charancs926-png/Meridian-W104/Images/Fusion Timeline.png

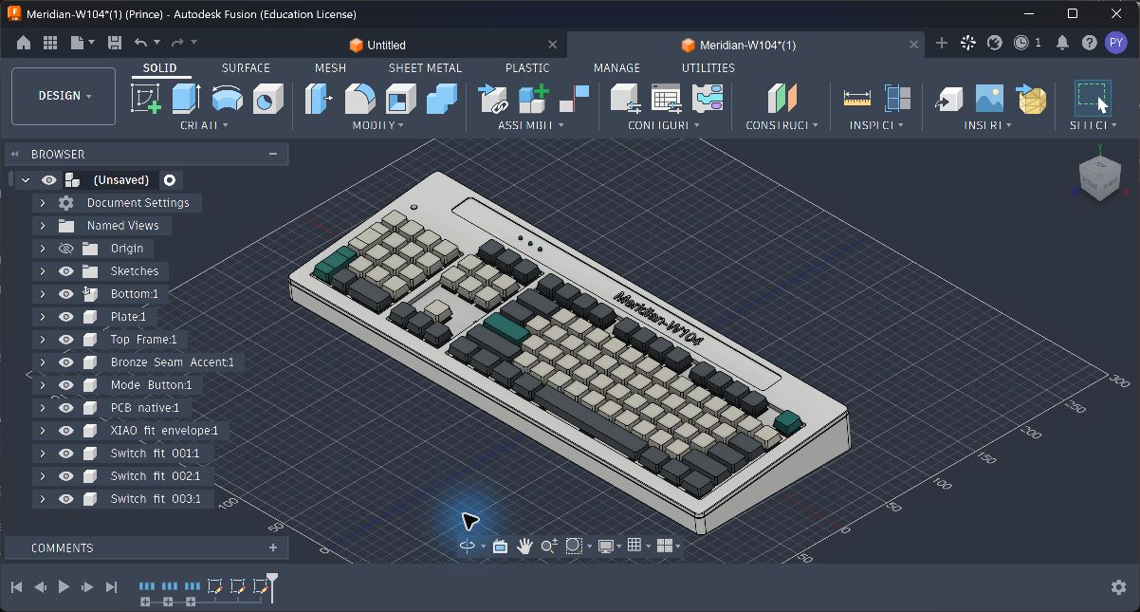
Images/Fusion Timeline.png
