charancs926-png/Meridian-W104/Images/KiCad PCB Bottom 3D.png

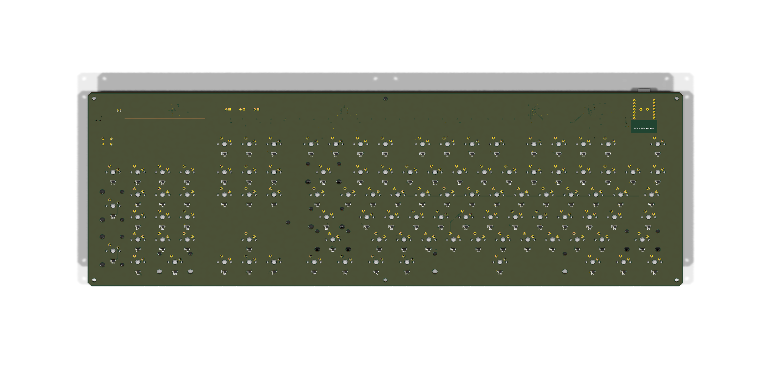
Images/KiCad PCB Bottom 3D.png
