charancs926-png/Meridian-W104/Images/PCB Layer 1.png

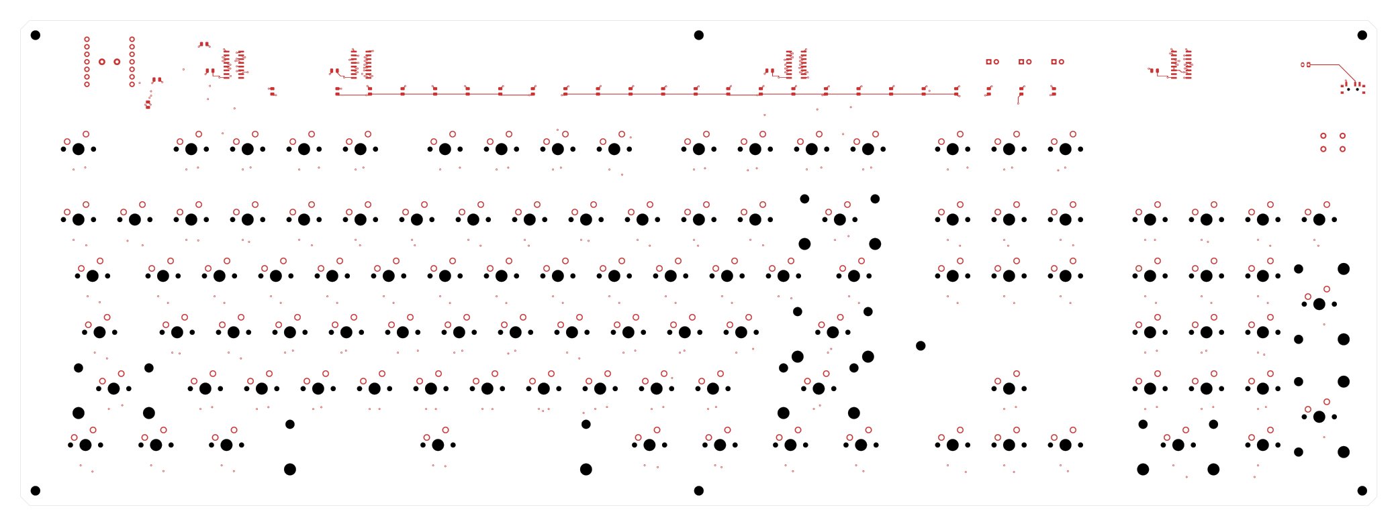
Images/PCB Layer 1.png
