charancs926-png/Meridian-W104/Images/PCB Layer 2.png

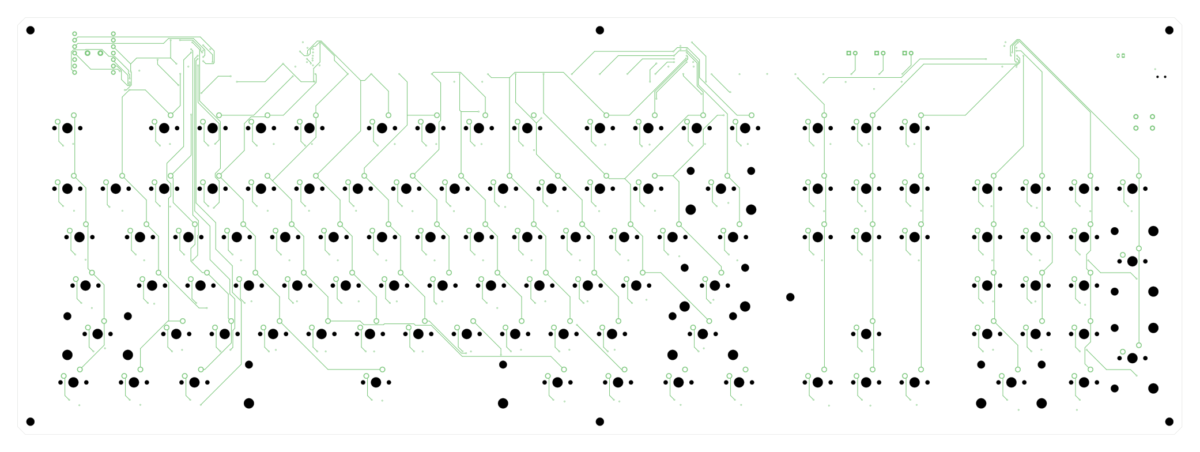
Images/PCB Layer 2.png
