charancs926-png/Meridian-W104/Images/PCB Layer 3.png

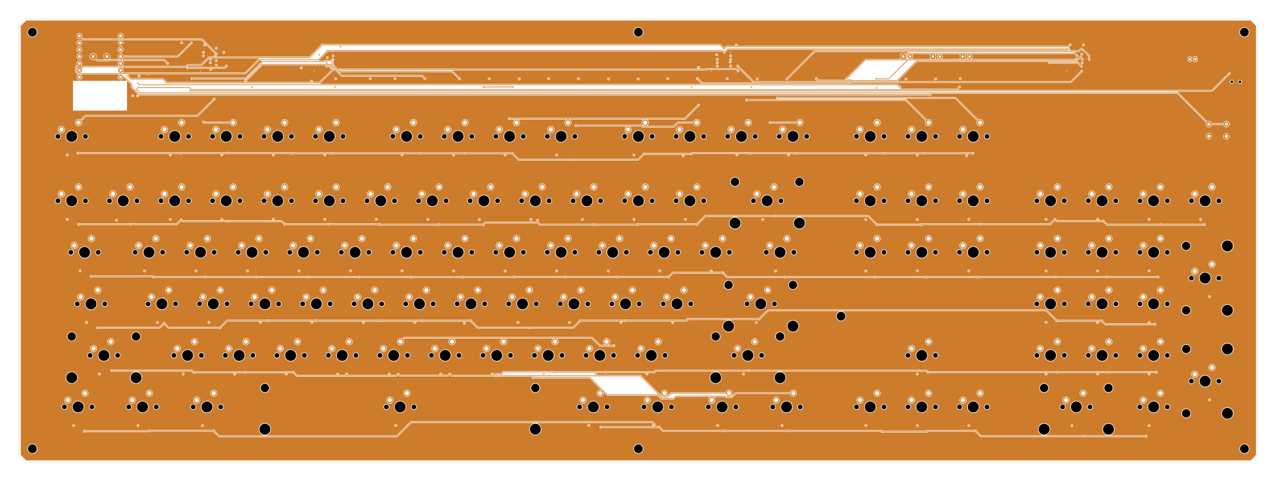
Images/PCB Layer 3.png
