charancs926-png/Meridian-W104/Images/PCB Layer 4.png

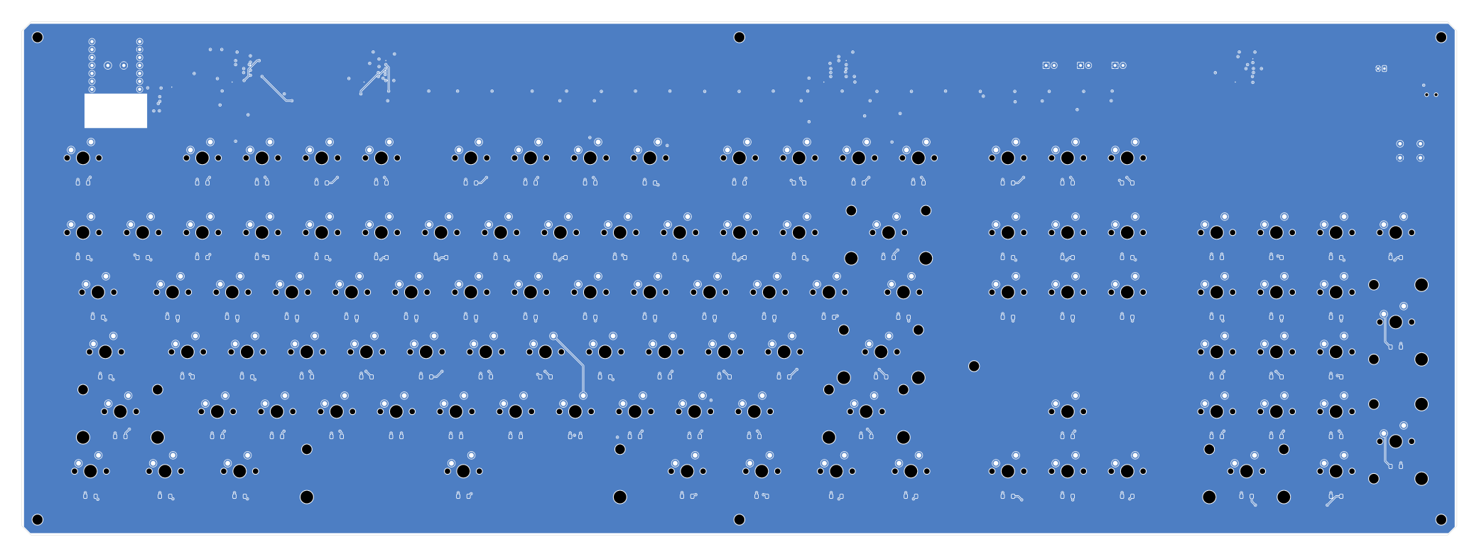
Images/PCB Layer 4.png
