charancs926-png/Meridian-W104/Images/PCB Layer 5.png

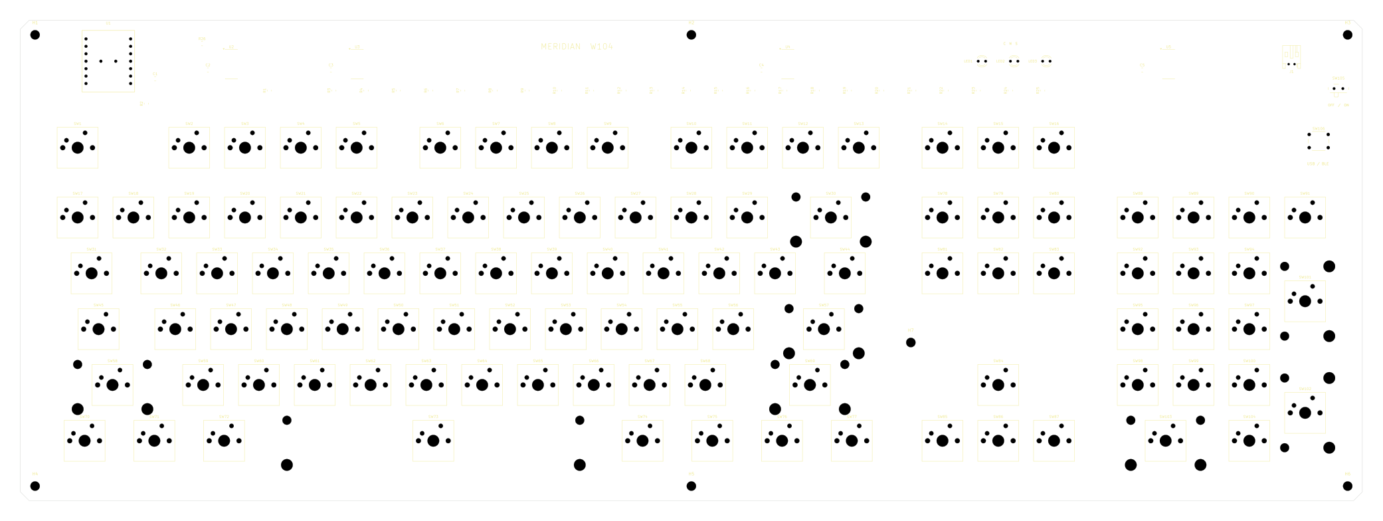
Images/PCB Layer 5.png
