charancs926-png/Meridian-W104/bom.csv

Name | Purpose | Quantity | TotalCost (INR) | UnitCost (INR) | TotalCostUSD | Link | Distributor
XIAO nRF52840 non-Plus | BLE / USB controller and module charger | 1 | 1451 | 1451 | 15.06 | https://www.lioncircuits.com/parts/102010448 | LionCircuits
SN74HC595D SOIC-16 | 6 row sink outputs | 1 | 32.2 | 16.1 | 0.33 | https://www.ktron.in/product/74hc595d-8-bit-shift-register-ic-smd/ | KTRON
SN74HC165D SOIC-16 | 22 column samples | 3 | 59.4 | 19.8 | 0.62 | https://www.ktron.in/product/74hc165d-ic-8-bit-shift-register-soic-16-nxp/ | KTRON
Cherry MX PCB-pattern switch, 5-pin | Soldered keys | 104 | 3850 | 350 | 39.96 | https://stackskb.com/store/menel-eight-nine-haku-linear-switch-pack-of-10/ | StacksKB
1N4148W SOD-123 | Per-key isolation | 104 | 108.16 | 1.04 | 1.12 | https://robu.in/product/1n4148w-slkor-75v-1v-4ns-150ma-sod-123-switching-diodes-rohs/ | Robu
22k 0805 1% resistor | Column bias | 22 | 10.08 | 0.42 | 0.1 | https://robu.in/product/ac0805fr-0722kl-yageo-res-thick-film-0805-22k-ohm-1-0-125w1-8w-%c2%b1100ppm-c-pad-smd-t-r-automotive-aec-q200/ | Robu
1k 0805 resistor | Lock indicator current limit | 3 | 13.8 | 0.46 | 0.14 | https://robu.in/product/rc0805jr-071kl-yageo-res-thick-film-0805-1k-ohm-5-0-125w1-8w-%c2%b1100ppm-c-pad-smd-t-r/ | Robu
100k 0805 resistor | Row output enable default OFF | 1 | 13.5 | 0.27 | 0.14 | https://robu.in/product/0805w8f1003t5e-uniohm-royal-ohm-125mw-thick-film-resistors-150v-%c2%b1100ppm-%e2%84%83%c2%b11-100k%cf%89-0805-chip-resistor-surface-mo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 | Robu
100n 0805 X7R, 10V or above | Logic decoupling | 4 | 30 | 1 | 0.31 | https://www.flyrobo.in/0805-100nf-50v-chip-capacitors | Flyrobo
10u 0805 X5R, 10V or above | Rail bulk capacitor | 1 | 10.6 | 2.65 | 0.11 | https://robu.in/product/08053d106kat2a-kyocera-avx-smd-multilayer-ceramic-capacitor-10-%c2%b5f-25-v-0805-2012-metric-%c2%b1-10-x5r/ | Robu
3mm LED, diffused, Vf compatible with 3.3V | Caps / Num / Scroll indicators | 3 | 18.8 | 0.94 | 0.2 | https://www.ktron.in/product/red-led-red-diffusion-3mm-th/ | KTRON
JST PH S2B-PH-K horizontal 2-pin | Battery connector | 1 | 16 | 8 | 0.17 | https://robu.in/product/s2b-ph-klfsn-jst-1x2p-2p-ph-tin-2-25%e2%84%8385%e2%84%83-2a-1-2mm-brass-bend-insert-push-pullp2mm-wire-to-board-connector-rohs/ | Robu
PCM12-pattern SMD SPDT slide switch | Battery disconnect | 1 | 66 | 66 | 0.68 | https://robu.in/product/pcm12smtr-ck-standing-paste-single-pole-double-throw-spdt-6v-smd-slide-switches-rohs/ | Robu
6mm THT tactile pushbutton | Transport toggle / bond reset | 1 | 3 | 3 | 0.03 | https://www.tomsonelectronics.com/products/tactile-push-button-micro-switch-6x6x4-3mm | Tomson
Protected 3.7V 500mAh LiPo 502248P (bare leads) | Wireless power; maximum assembled envelope 60x28x6mm | 1 | 299 | 299 | 3.1 | https://probots.co.in/3-7v-500mah-lipo-battery-502248-open-ended.html | Probots
JST-PH2.0 2-pin female pigtail to bare wire | Adapt protected bare-lead battery to J1 | 1 | 4.13 | 4.13 | 0.04 | https://hubtronics.in/connectors/relimate_connectors/board_to_wire_relimate/1508 | Hubtronics
7-pin 2.54mm headers | Module mounting; two rows | 2 | 40 | 8 | 0.42 | https://www.flyrobo.in/40-pin-male-header-connector-strip-breakable-5pcs | Flyrobo
Flexible insulated wire | Module underside BAT+ / BAT- leads | 2 | 24 | 6 | 0.25 | https://robu.in/product/high-quality-ultra-flexible-28awg-silicone-wire-1000m-red/ | Robu
ANSI 104-key MX keycap set | User keycaps; 6.25u spacebar | 1 | 1000 | 1000 | 10.38 | https://stackskb.com/store/stackspbt-blank-white-cherry-profile-keycaps-113-key/ | StacksKB
Durock V2 PCB screw-in stabilizer kit (7x2U + 1x6.25U) | Seven wide keys and 6.25U spacebar | 1 | 2365 | 2365 | 24.54 | https://stackskb.com/store/durock-clear-screw-in-stabilizers-v2/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 | StacksKB
M3x30mm DIN912 socket-head SS304 screws (10pc pack) | 3 concealed rear mounts | 1 | 116 | 116 | 1.2 | https://rpishop.in/products/ss-allen-cap-m3?variant=45146051510424 | RPI Shop
M3x15mm DIN912 socket-head SS304 screws (10pc pack) | 3 concealed front mounts | 1 | 88 | 88 | 0.91 | https://rpishop.in/products/ss-allen-cap-m3?variant=45146051412120 | RPI Shop
M3x20mm DIN912 socket-head SS304 screws (10pc pack) | 1 concealed centre mounts | 1 | 92 | 92 | 0.95 | https://rpishop.in/products/ss-allen-cap-m3?variant=45146051444888 | RPI Shop
M3 insert assortment; select 5mm long x4.2mm OD | Seven top-frame bosses, 3.9mm pilot holes | 1 | 1519 | 1519 | 15.76 | https://robu.in/product/brass-heat-set-insert-nut-hot-melt-knurled-threaded-m3-400pcs-kit/ | Robu
Meridian W104 four-layer PCB, 1.6mm | Final checked four-layer Gerber and drill package | 5 | 8647.58 | 1729.516 | 89.25 | https://cart.jlcpcb.com/shopcart/cart/ | JLCPCB
Printed case set | Bottom, plate, top frame, seam accent, mode button | 1 | 0 | 0 | 0 | https://printlegion.hackclub.com/ | Printing Legion
TOTAL |  |  | 19877.25 |  | 205.77
