charancs926-png/Meridian-W104/Fabrication/Assembly BOM.csv

Reference | Value | Footprint | Side | Technology | Notes
C1 | 10u / 10V | Capacitor_SMD:C_0805_2012Metric | Top | SMD
C2 | 100n | Capacitor_SMD:C_0805_2012Metric | Top | SMD
C3 | 100n | Capacitor_SMD:C_0805_2012Metric | Top | SMD
C4 | 100n | Capacitor_SMD:C_0805_2012Metric | Top | SMD
C5 | 100n | Capacitor_SMD:C_0805_2012Metric | Top | SMD
D1 | 1N4148W | Diode_SMD:D_SOD-123 | Bottom | SMD
D10 | 1N4148W | Diode_SMD:D_SOD-123 | Bottom | SMD
D100 | 1N4148W | Diode_SMD:D_SOD-123 | Bottom | SMD
D101 | 1N4148W | Diode_SMD:D_SOD-123 | Bottom | SMD
D102 | 1N4148W | Diode_SMD:D_SOD-123 | Bottom | SMD
D103 | 1N4148W | Diode_SMD:D_SOD-123 | Bottom | SMD
D104 | 1N4148W | Diode_SMD:D_SOD-123 | Bottom | SMD
D11 | 1N4148W | Diode_SMD:D_SOD-123 | Bottom | SMD
D12 | 1N4148W | Diode_SMD:D_SOD-123 | Bottom | SMD
D13 | 1N4148W | Diode_SMD:D_SOD-123 | Bottom | SMD
D14 | 1N4148W | Diode_SMD:D_SOD-123 | Bottom | SMD
D15 | 1N4148W | Diode_SMD:D_SOD-123 | Bottom | SMD
D16 | 1N4148W | Diode_SMD:D_SOD-123 | Bottom | SMD
D17 | 1N4148W | Diode_SMD:D_SOD-123 | Bottom | SMD
D18 | 1N4148W | Diode_SMD:D_SOD-123 | Bottom | SMD
D19 | 1N4148W | Diode_SMD:D_SOD-123 | Bottom | SMD
D2 | 1N4148W | Diode_SMD:D_SOD-123 | Bottom | SMD
D20 | 1N4148W | Diode_SMD:D_SOD-123 | Bottom | SMD
D21 | 1N4148W | Diode_SMD:D_SOD-123 | Bottom | SMD
D22 | 1N4148W | Diode_SMD:D_SOD-123 | Bottom | SMD
D23 | 1N4148W | Diode_SMD:D_SOD-123 | Bottom | SMD
D24 | 1N4148W | Diode_SMD:D_SOD-123 | Bottom | SMD
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
SW86 | 1u | Button_Switch_Keyboard:SW_Cherry_MX_1.00u_PCB | Top | THT | Soldered MX PCB switches, not hot-swap.
SW87 | 1u | Button_Switch_Keyboard:SW_Cherry_MX_1.00u_PCB | Top | THT | Soldered MX PCB switches, not hot-swap.
SW88 | 1u | Button_Switch_Keyboard:SW_Cherry_MX_1.00u_PCB | Top | THT | Soldered MX PCB switches, not hot-swap.
SW89 | 1u | Button_Switch_Keyboard:SW_Cherry_MX_1.00u_PCB | Top | THT | Soldered MX PCB switches, not hot-swap.
SW9 | 1u | Button_Switch_Keyboard:SW_Cherry_MX_1.00u_PCB | Top | THT | Soldered MX PCB switches, not hot-swap.
SW90 | 1u | Button_Switch_Keyboard:SW_Cherry_MX_1.00u_PCB | Top | THT | Soldered MX PCB switches, not hot-swap.
SW91 | 1u | Button_Switch_Keyboard:SW_Cherry_MX_1.00u_PCB | Top | THT | Soldered MX PCB switches, not hot-swap.
SW92 | 1u | Button_Switch_Keyboard:SW_Cherry_MX_1.00u_PCB | Top | THT | Soldered MX PCB switches, not hot-swap.
SW93 | 1u | Button_Switch_Keyboard:SW_Cherry_MX_1.00u_PCB | Top | THT | Soldered MX PCB switches, not hot-swap.
SW94 | 1u | Button_Switch_Keyboard:SW_Cherry_MX_1.00u_PCB | Top | THT | Soldered MX PCB switches, not hot-swap.
SW95 | 1u | Button_Switch_Keyboard:SW_Cherry_MX_1.00u_PCB | Top | THT | Soldered MX PCB switches, not hot-swap.
SW96 | 1u | Button_Switch_Keyboard:SW_Cherry_MX_1.00u_PCB | Top | THT | Soldered MX PCB switches, not hot-swap.
SW97 | 1u | Button_Switch_Keyboard:SW_Cherry_MX_1.00u_PCB | Top | THT | Soldered MX PCB switches, not hot-swap.
SW98 | 1u | Button_Switch_Keyboard:SW_Cherry_MX_1.00u_PCB | Top | THT | Soldered MX PCB switches, not hot-swap.
SW99 | 1u | Button_Switch_Keyboard:SW_Cherry_MX_1.00u_PCB | Top | THT | Soldered MX PCB switches, not hot-swap.
U1 | XIAO nRF52840 | Meridian:XIAO_Carrier | Top | THT | Original XIAO nRF52840 non-Plus on two 7-pin headers. BAT+/- underside pads wired to carrier pads 15/16; do not treat as header pins.
U2 | SN74HC595D | Package_SO:SOIC-16_3.9x9.9mm_P1.27mm | Top | SMD
U3 | SN74HC165D | Package_SO:SOIC-16_3.9x9.9mm_P1.27mm | Top | SMD
U4 | SN74HC165D | Package_SO:SOIC-16_3.9x9.9mm_P1.27mm | Top | SMD
U5 | SN74HC165D | Package_SO:SOIC-16_3.9x9.9mm_P1.27mm | Top | SMD
