charancs926-png/Meridian-W104/BOM Images/Flyrobo Cart.jpg

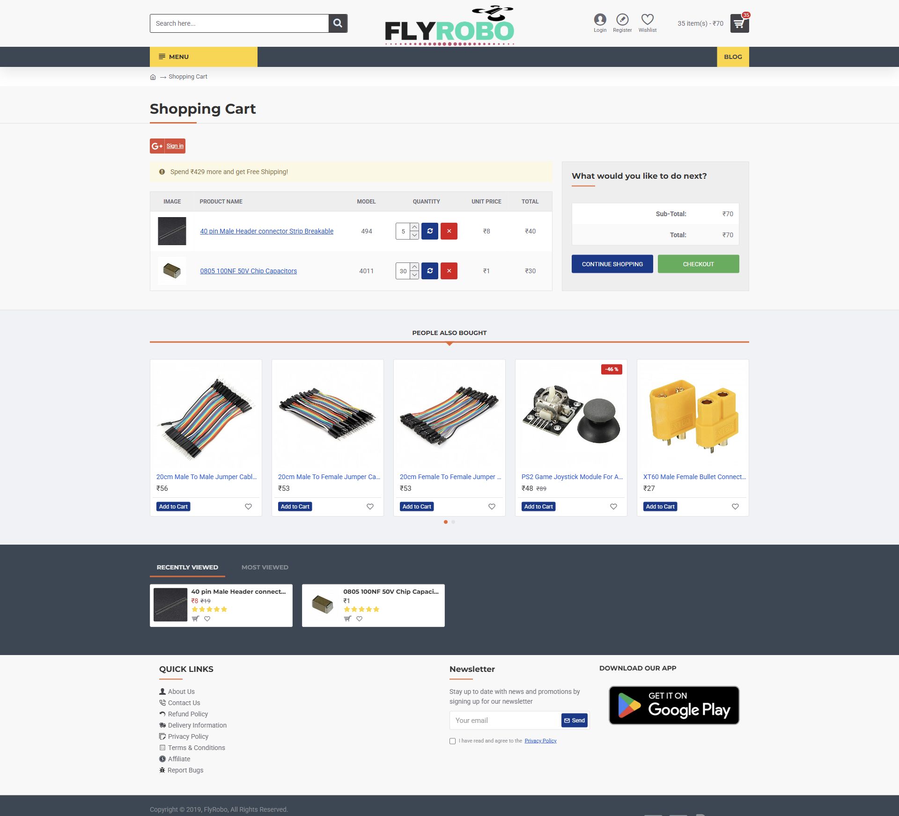
BOM Images/Flyrobo Cart.jpg
