charancs926-png/Meridian-W104/BOM Images/Hubtronics Cart.jpg

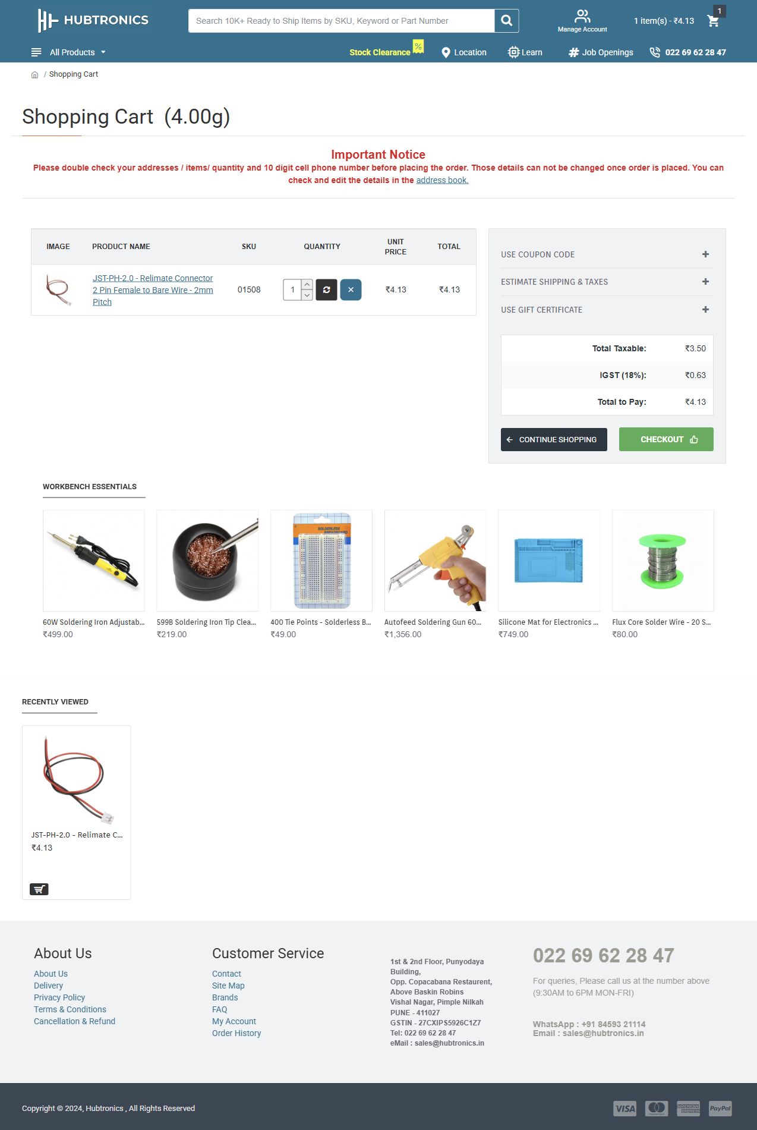
BOM Images/Hubtronics Cart.jpg
