charancs926-png/Meridian-W104/BOM Images/KTRON Cart.jpg

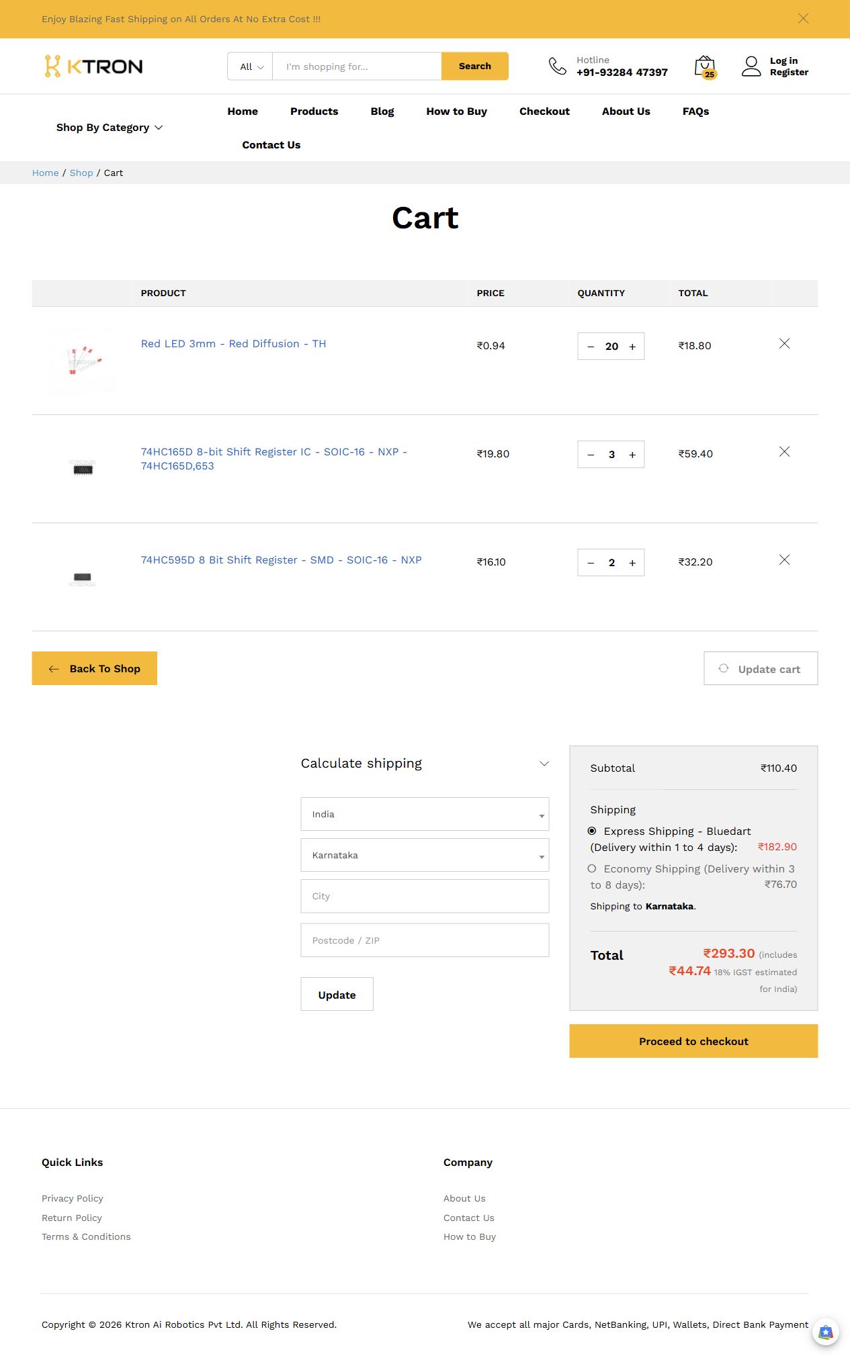
BOM Images/KTRON Cart.jpg
