charancs926-png/Meridian-W104/BOM Images/LionCircuits Cart.jpg

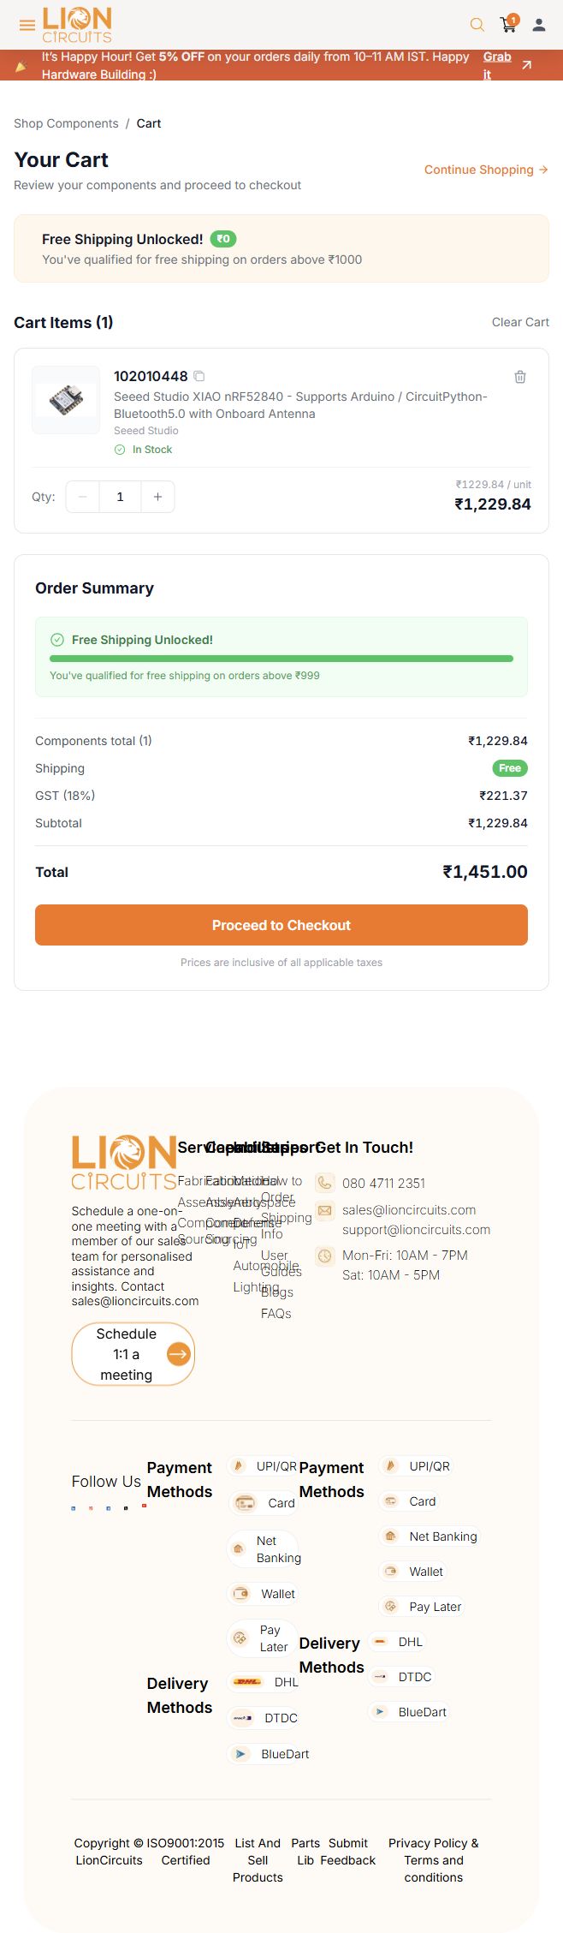
BOM Images/LionCircuits Cart.jpg
