charancs926-png/Meridian-W104/BOM Images/Probots Battery Listing.jpg

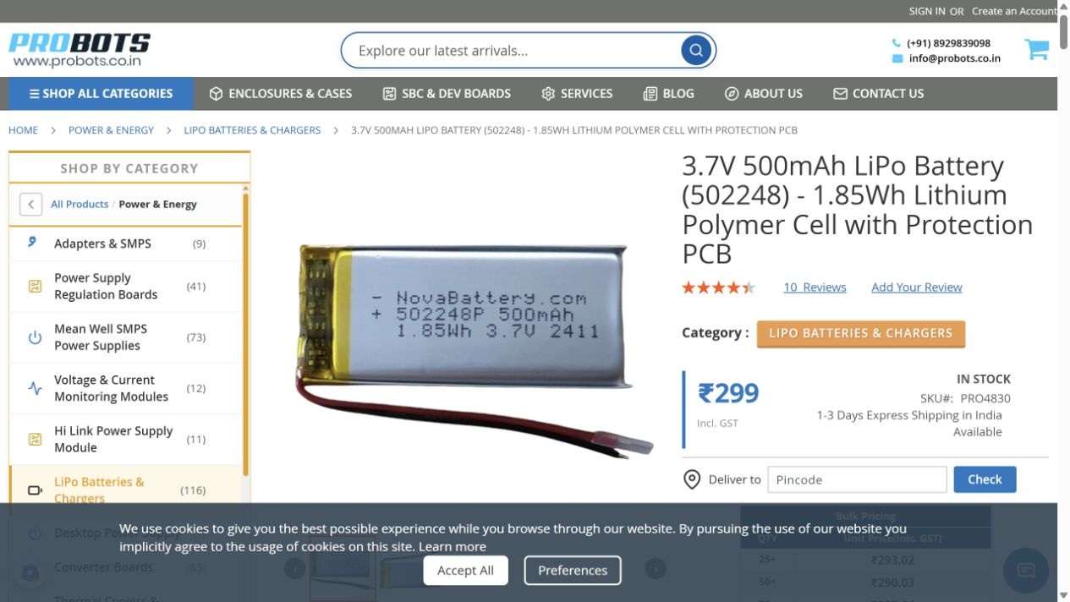
BOM Images/Probots Battery Listing.jpg
