charancs926-png/Meridian-W104/BOM Images/Robu Cart.jpg

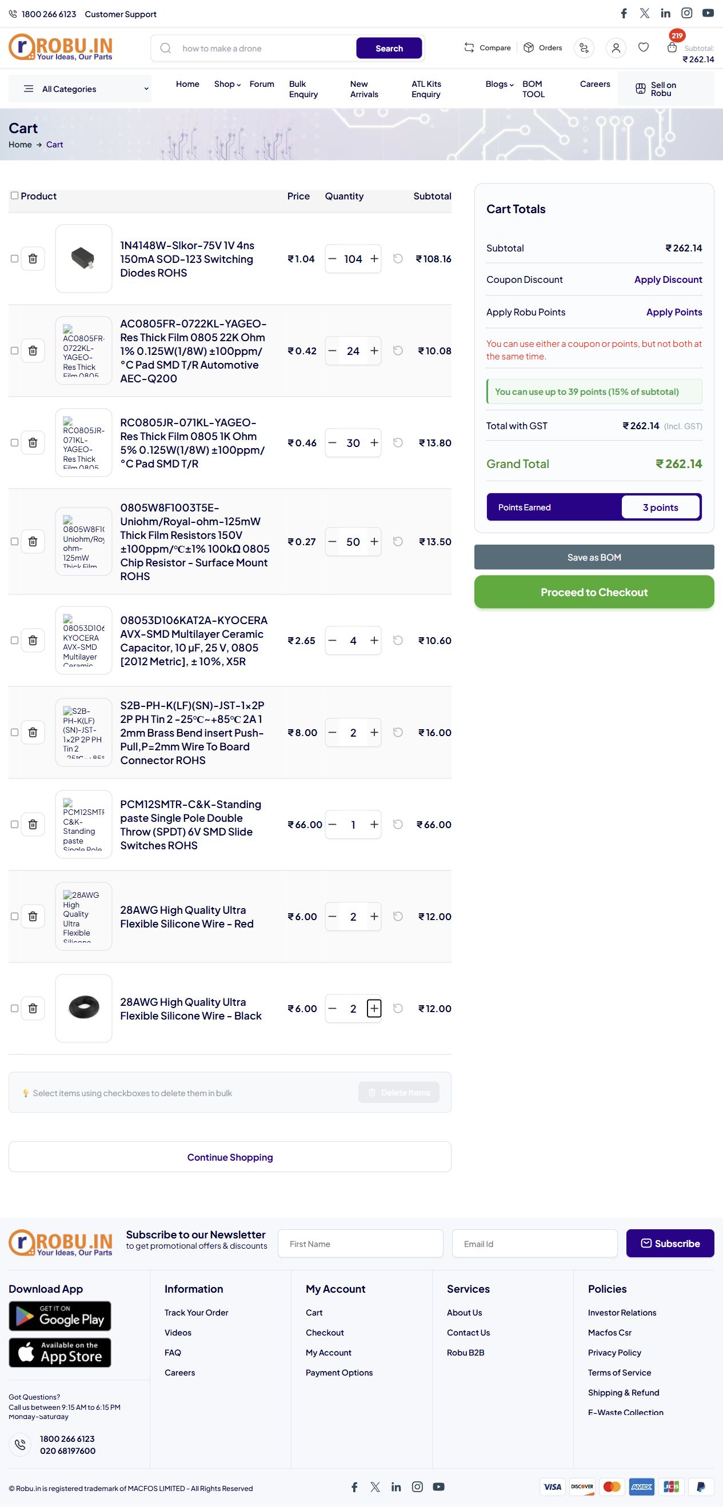
BOM Images/Robu Cart.jpg
