charancs926-png/Meridian-W104/BOM Images/Robu Inserts Cart.jpg

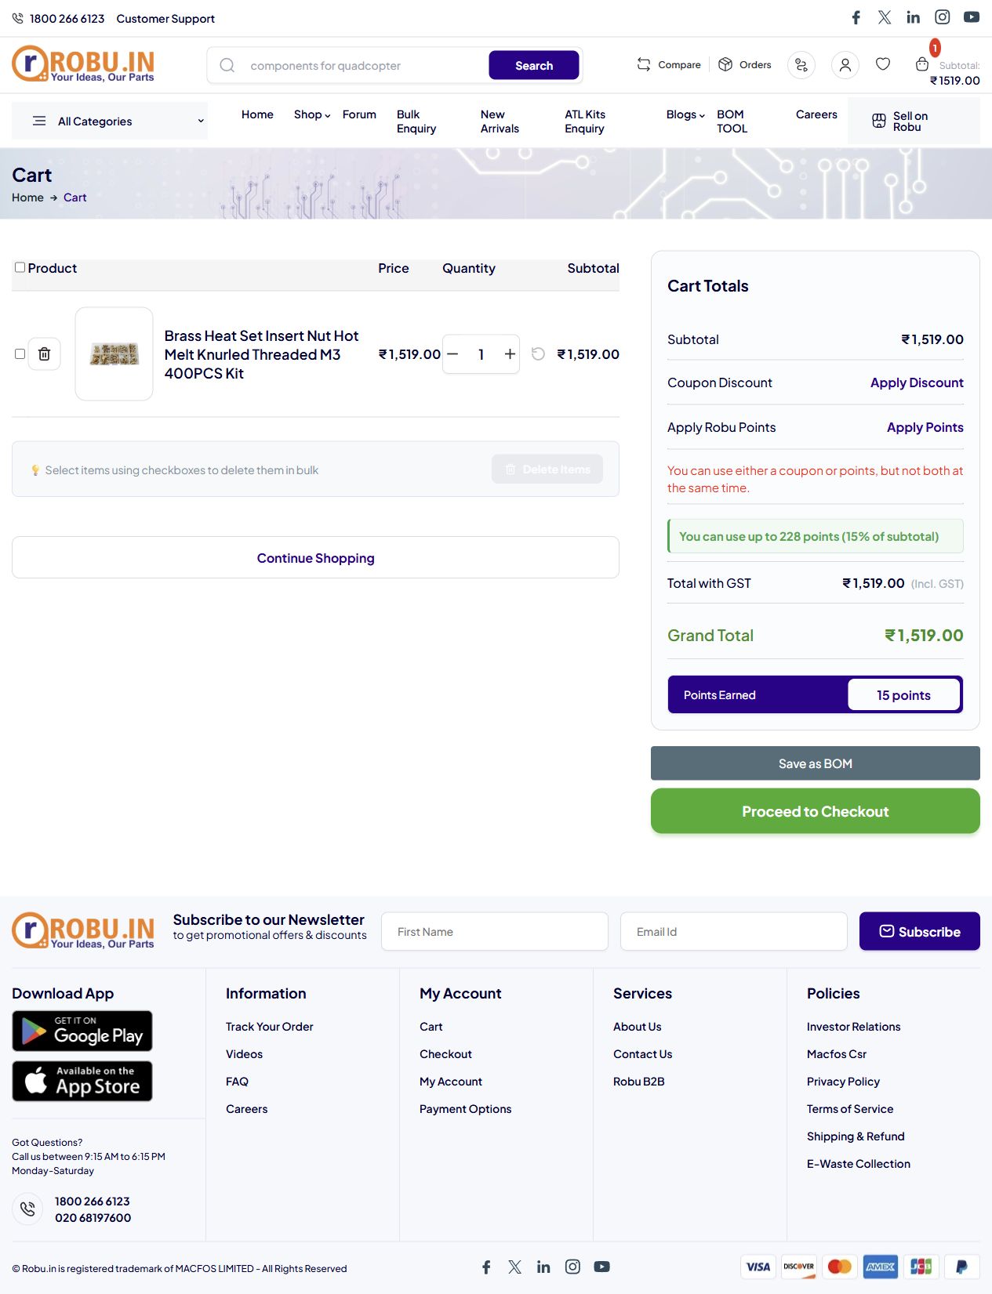
BOM Images/Robu Inserts Cart.jpg
