charancs926-png/Meridian-W104/BOM Images/RPI Shop Cart.jpg

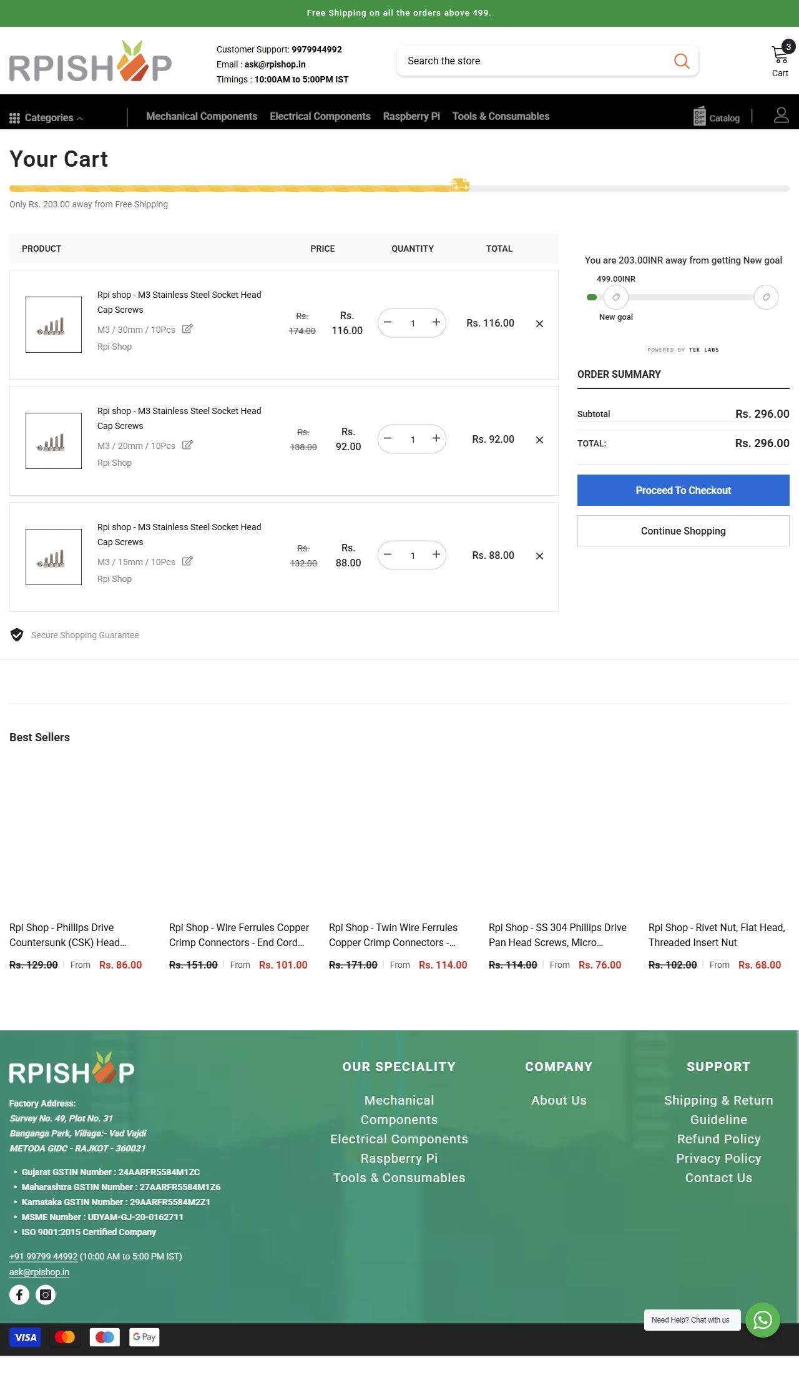
BOM Images/RPI Shop Cart.jpg
