charancs926-png/Meridian-W104/BOM Images/Screenshot 2026-10-08 165828.png

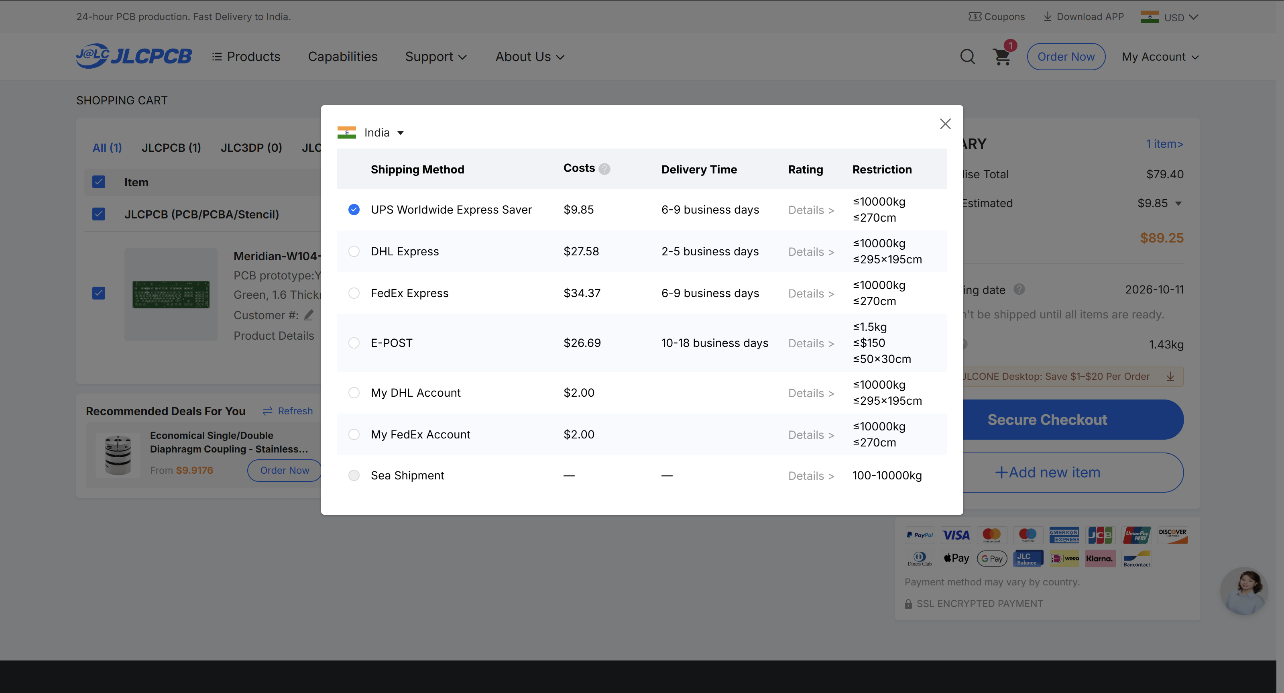
BOM Images/Screenshot 2026-10-08 165828.png
