charancs926-png/Meridian-W104/BOM Images/StacksKB Cart.jpg

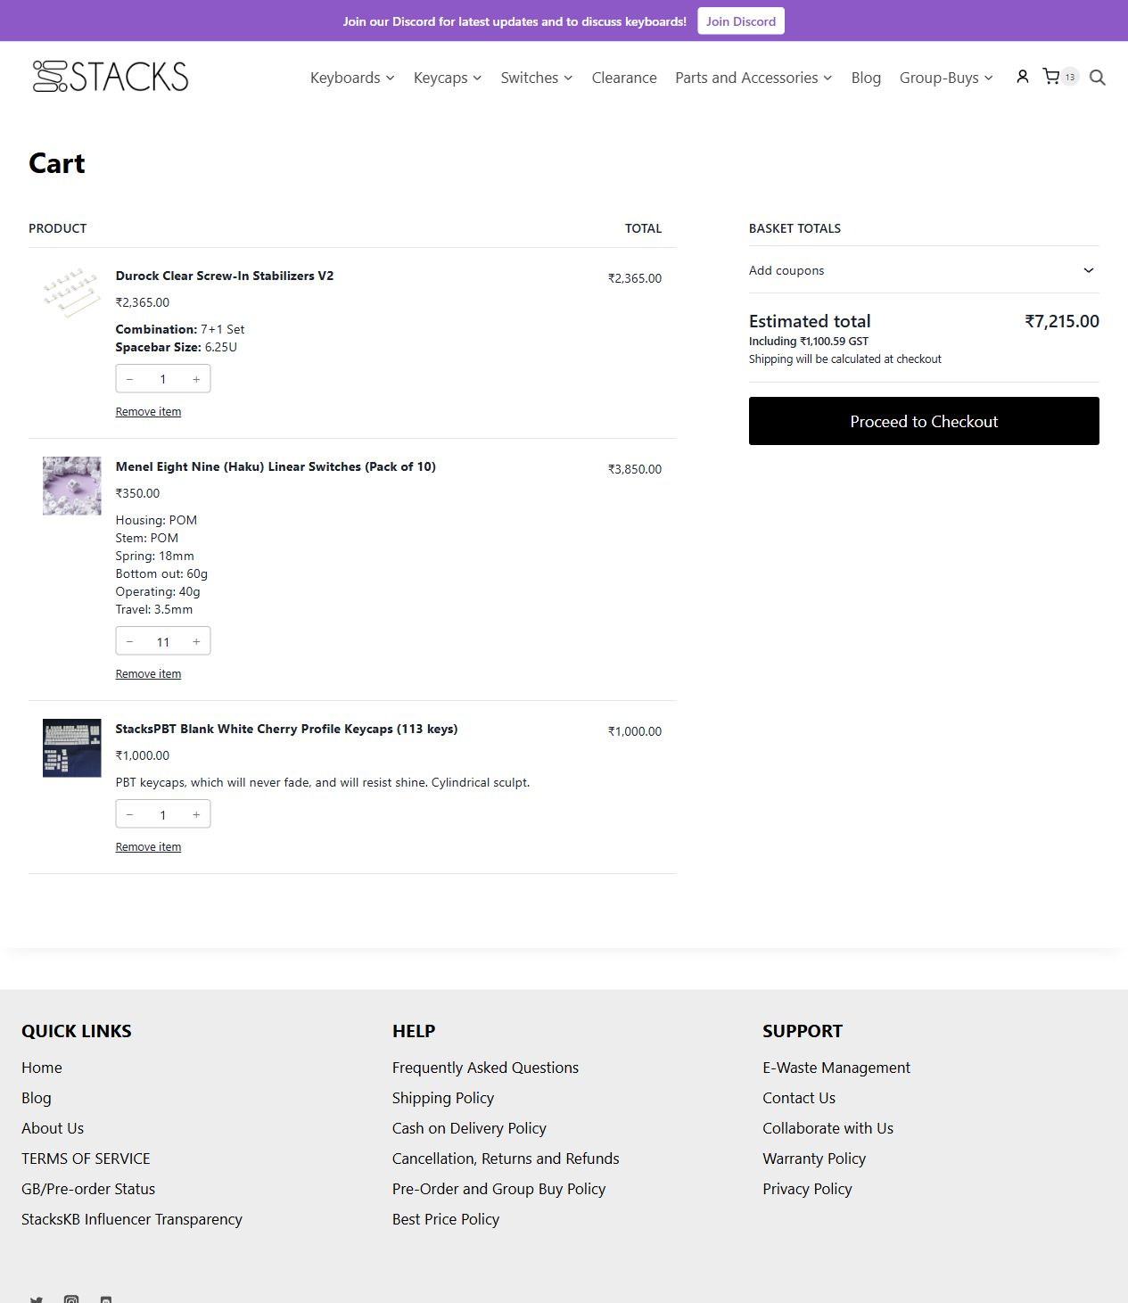
BOM Images/StacksKB Cart.jpg
