charancs926-png/Meridian-W104/BOM Images/Tomson Cart.jpg

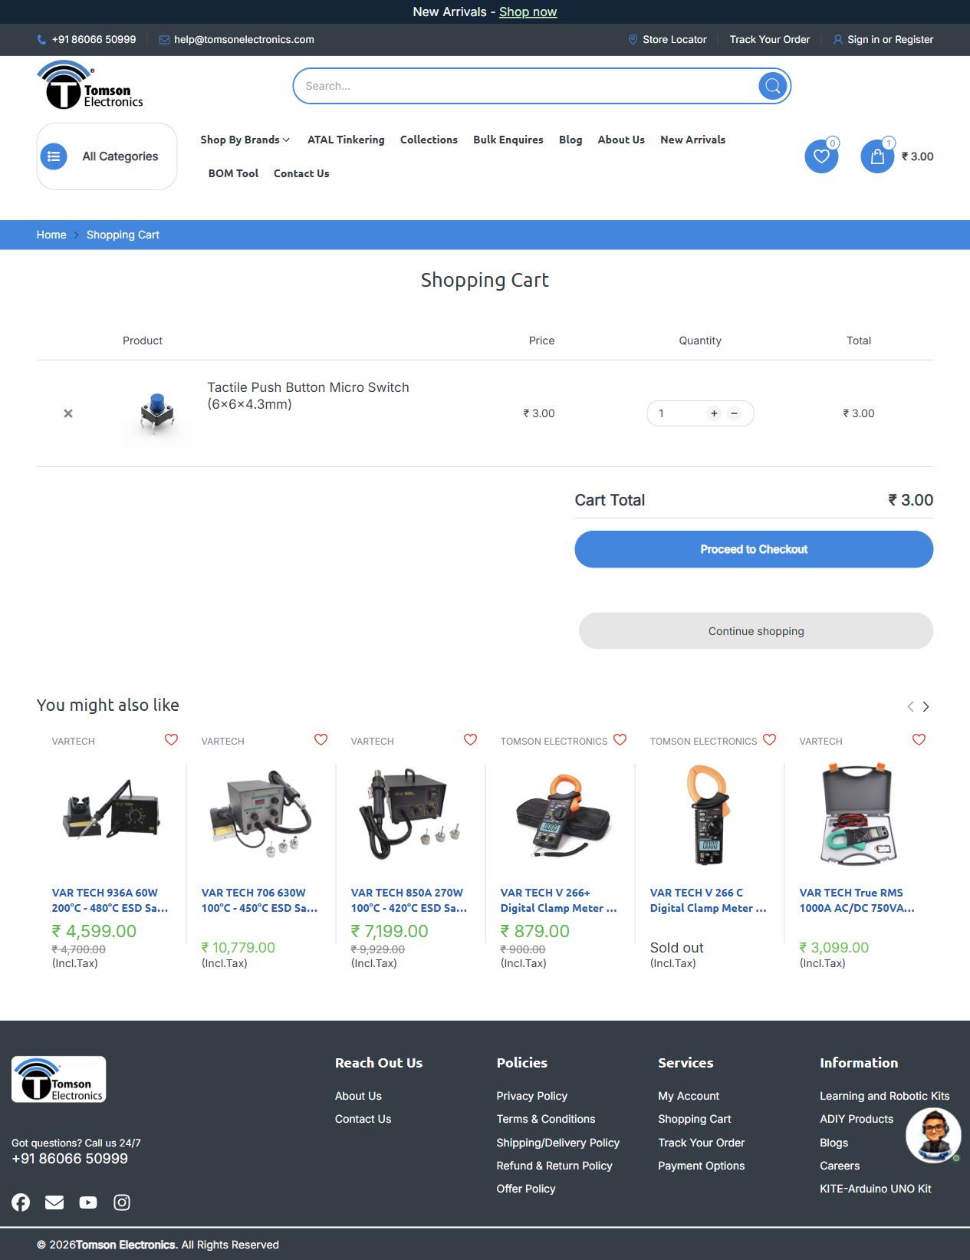
BOM Images/Tomson Cart.jpg
