charancs926-png/Meridian-W104/CAD/Full Meridian W104/Meridian W104.step

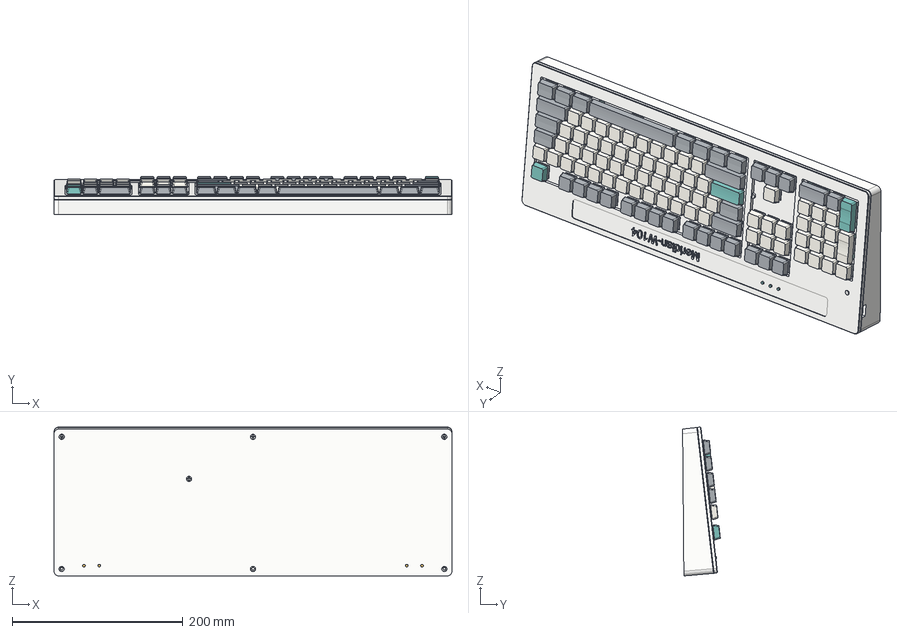
[picture p29: CAD file, 2026-10-09]
CAD/Full Meridian W104/Meridian W104.step
466.1 x 44.3 x 174.4 mm
Bottom
Plate
Top_Frame
Bronze_Seam_Accent
Mode_Button
PCB_native
XIAO_fit_envelope
Switch_fit_001
Switch_fit_002
Switch_fit_003
Switch_fit_004
Switch_fit_005
Switch_fit_006
Switch_fit_007
Switch_fit_008
Switch_fit_009
Switch_fit_010
Switch_fit_011
Switch_fit_012
Switch_fit_013
Switch_fit_014
Switch_fit_015
Switch_fit_016
Switch_fit_017
Switch_fit_018
Switch_fit_019
Switch_fit_020
Switch_fit_021
Switch_fit_022
Switch_fit_023
Switch_fit_024
Switch_fit_025
Switch_fit_026
Switch_fit_027
Switch_fit_028
Switch_fit_029
Switch_fit_030
Switch_fit_031
Switch_fit_032
Switch_fit_033
Switch_fit_034
Switch_fit_035
Switch_fit_036
Switch_fit_037
Switch_fit_038
Switch_fit_039
Switch_fit_040
Switch_fit_041
Switch_fit_042
Switch_fit_043
Switch_fit_044
Switch_fit_045
Switch_fit_046
Switch_fit_047
Switch_fit_048
Switch_fit_049
Switch_fit_050
Switch_fit_051
Switch_fit_052
Switch_fit_053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
