charancs926-png/Meridian-W104/CAD/Printing Files/Bronze Seam Accent.stl

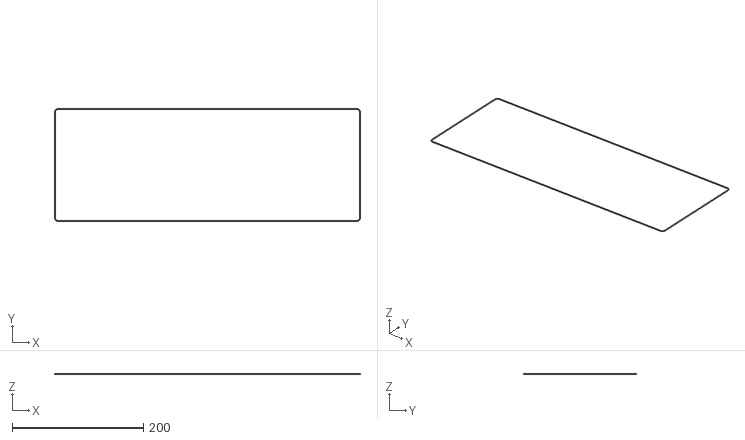
[picture p30: CAD file, 2026-10-09]
CAD/Printing Files/Bronze Seam Accent.stl
466.1 x 172.0 x 0.8
