charancs926-png/Meridian-W104/PCB/3D Models/XIAO Fit Envelope.step

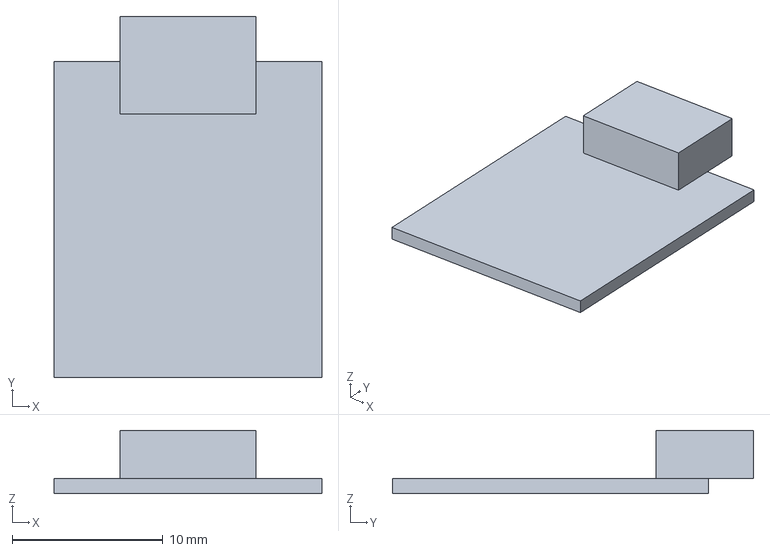
[picture p31: CAD file, 2026-10-09]
PCB/3D Models/XIAO Fit Envelope.step
17.8 x 24.0 x 4.20 mm
