charancs926-png/Meridian-W104/CAD/Printing Files/Bottom.stl

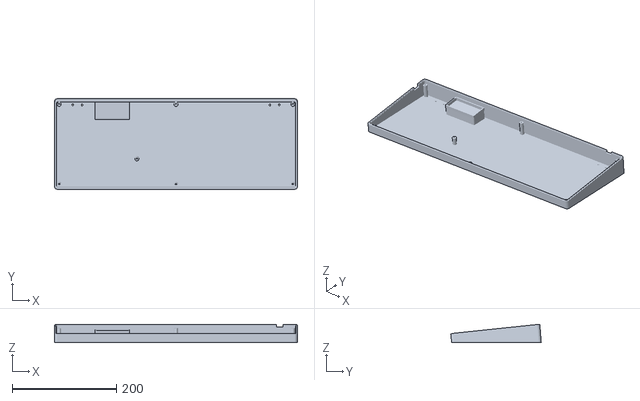
[picture p32: CAD file, 2026-10-09]
CAD/Printing Files/Bottom.stl
466.1 x 173.8 x 35.3
