charancs926-png/Meridian-W104/PCB/3D Models/MX PCB Switch.step

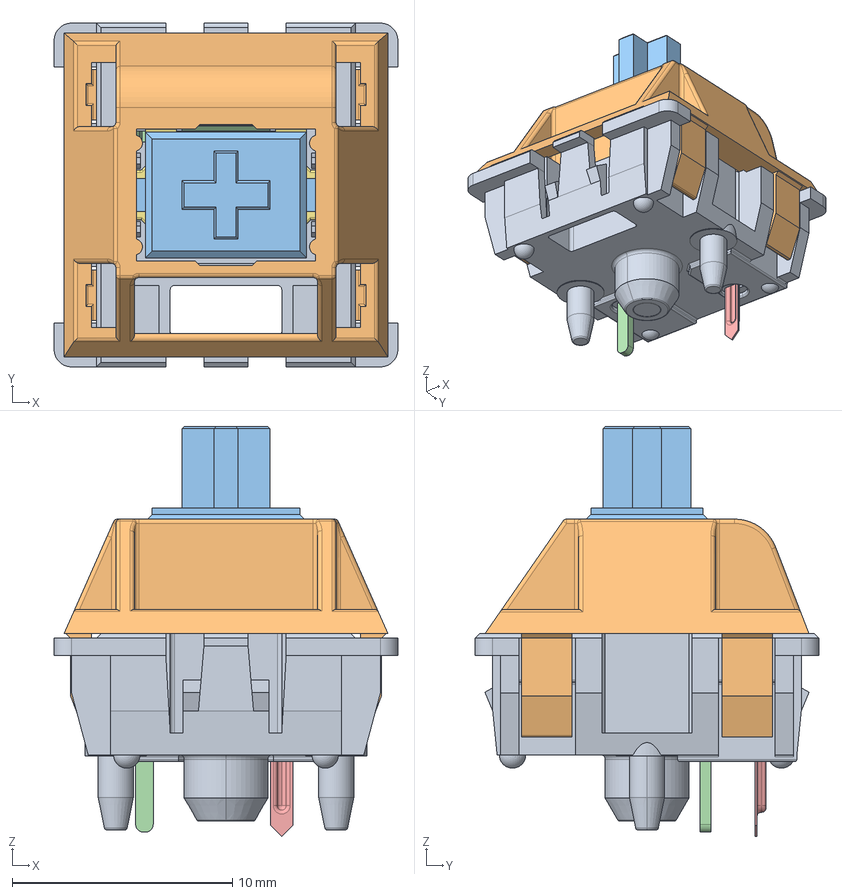
[picture p33: CAD file, 2026-10-09]
PCB/3D Models/MX PCB Switch.step
15.6 x 15.6 x 18.6 mm
