charancs926-png/Meridian-W104/CAD/Printing Files/Mode Button.stl

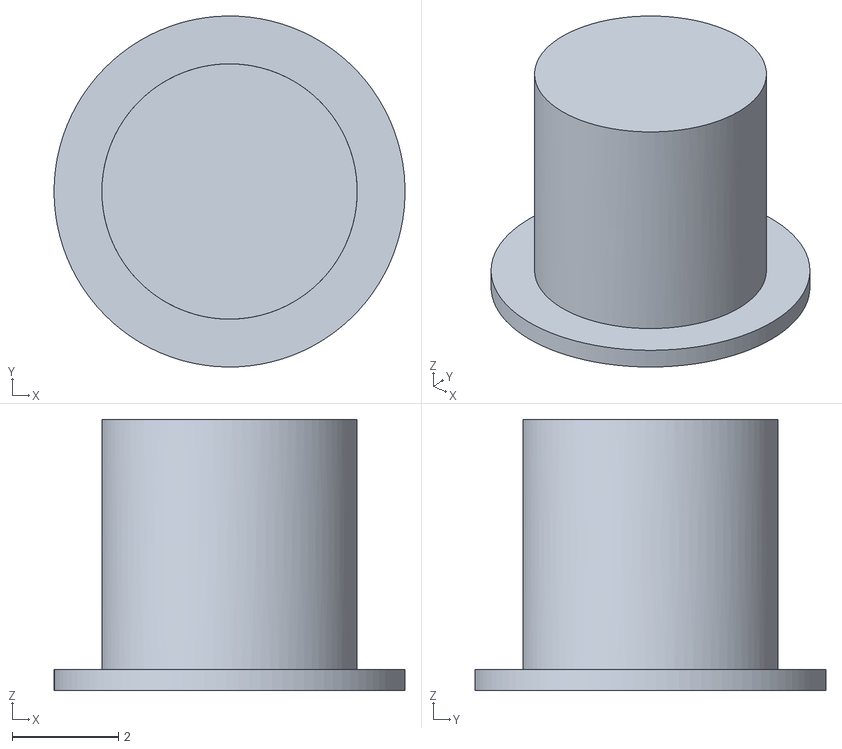
[picture p34: CAD file, 2026-10-09]
CAD/Printing Files/Mode Button.stl
6.60 x 6.60 x 5.10
