charancs926-png/Meridian-W104/CAD/Printing Files/Top Frame.stl

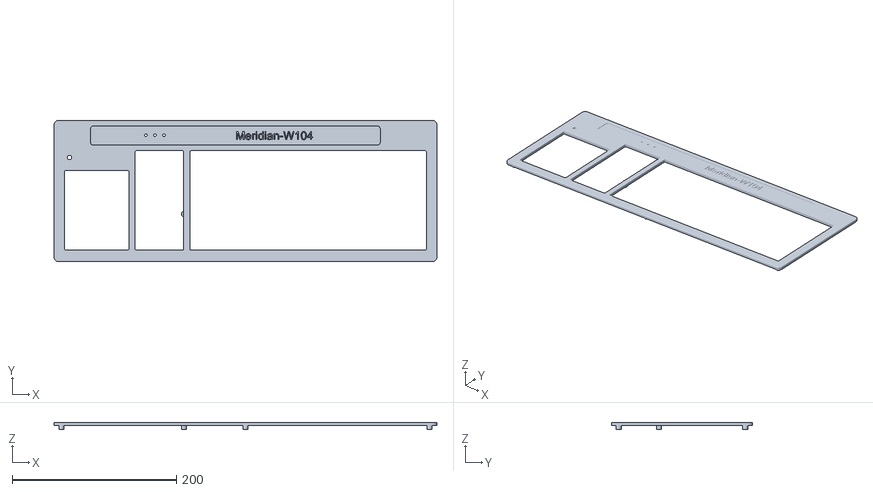
[picture p35: CAD file, 2026-10-09]
CAD/Printing Files/Top Frame.stl
466.1 x 172.0 x 9.10
