charancs926-png/Meridian-W104/CAD/Printing Files/Plate.stl

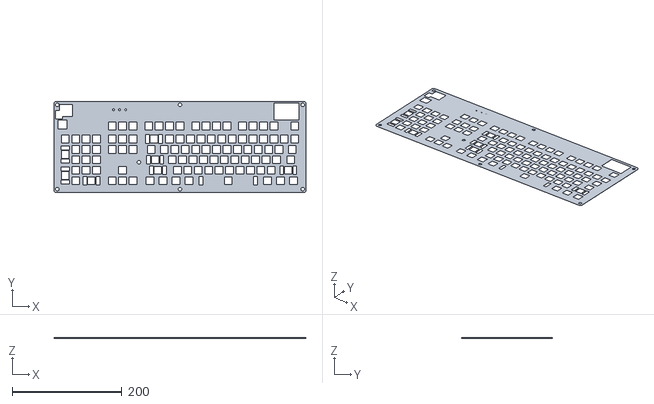
[picture p36: CAD file, 2026-10-09]
CAD/Printing Files/Plate.stl
460.1 x 166.0 x 1.50
