charancs926-png/Meridian-W104/(list of files, cad)

Other CAD files:
PCB/nRF52840/XIAO nRF52840 - Fit Envelope.step
PCB/3D Models/SW_Cherry_MX_PCB.stp
