charancs926-png/Meridian-W104/PDFs/Meridian W104.pdf

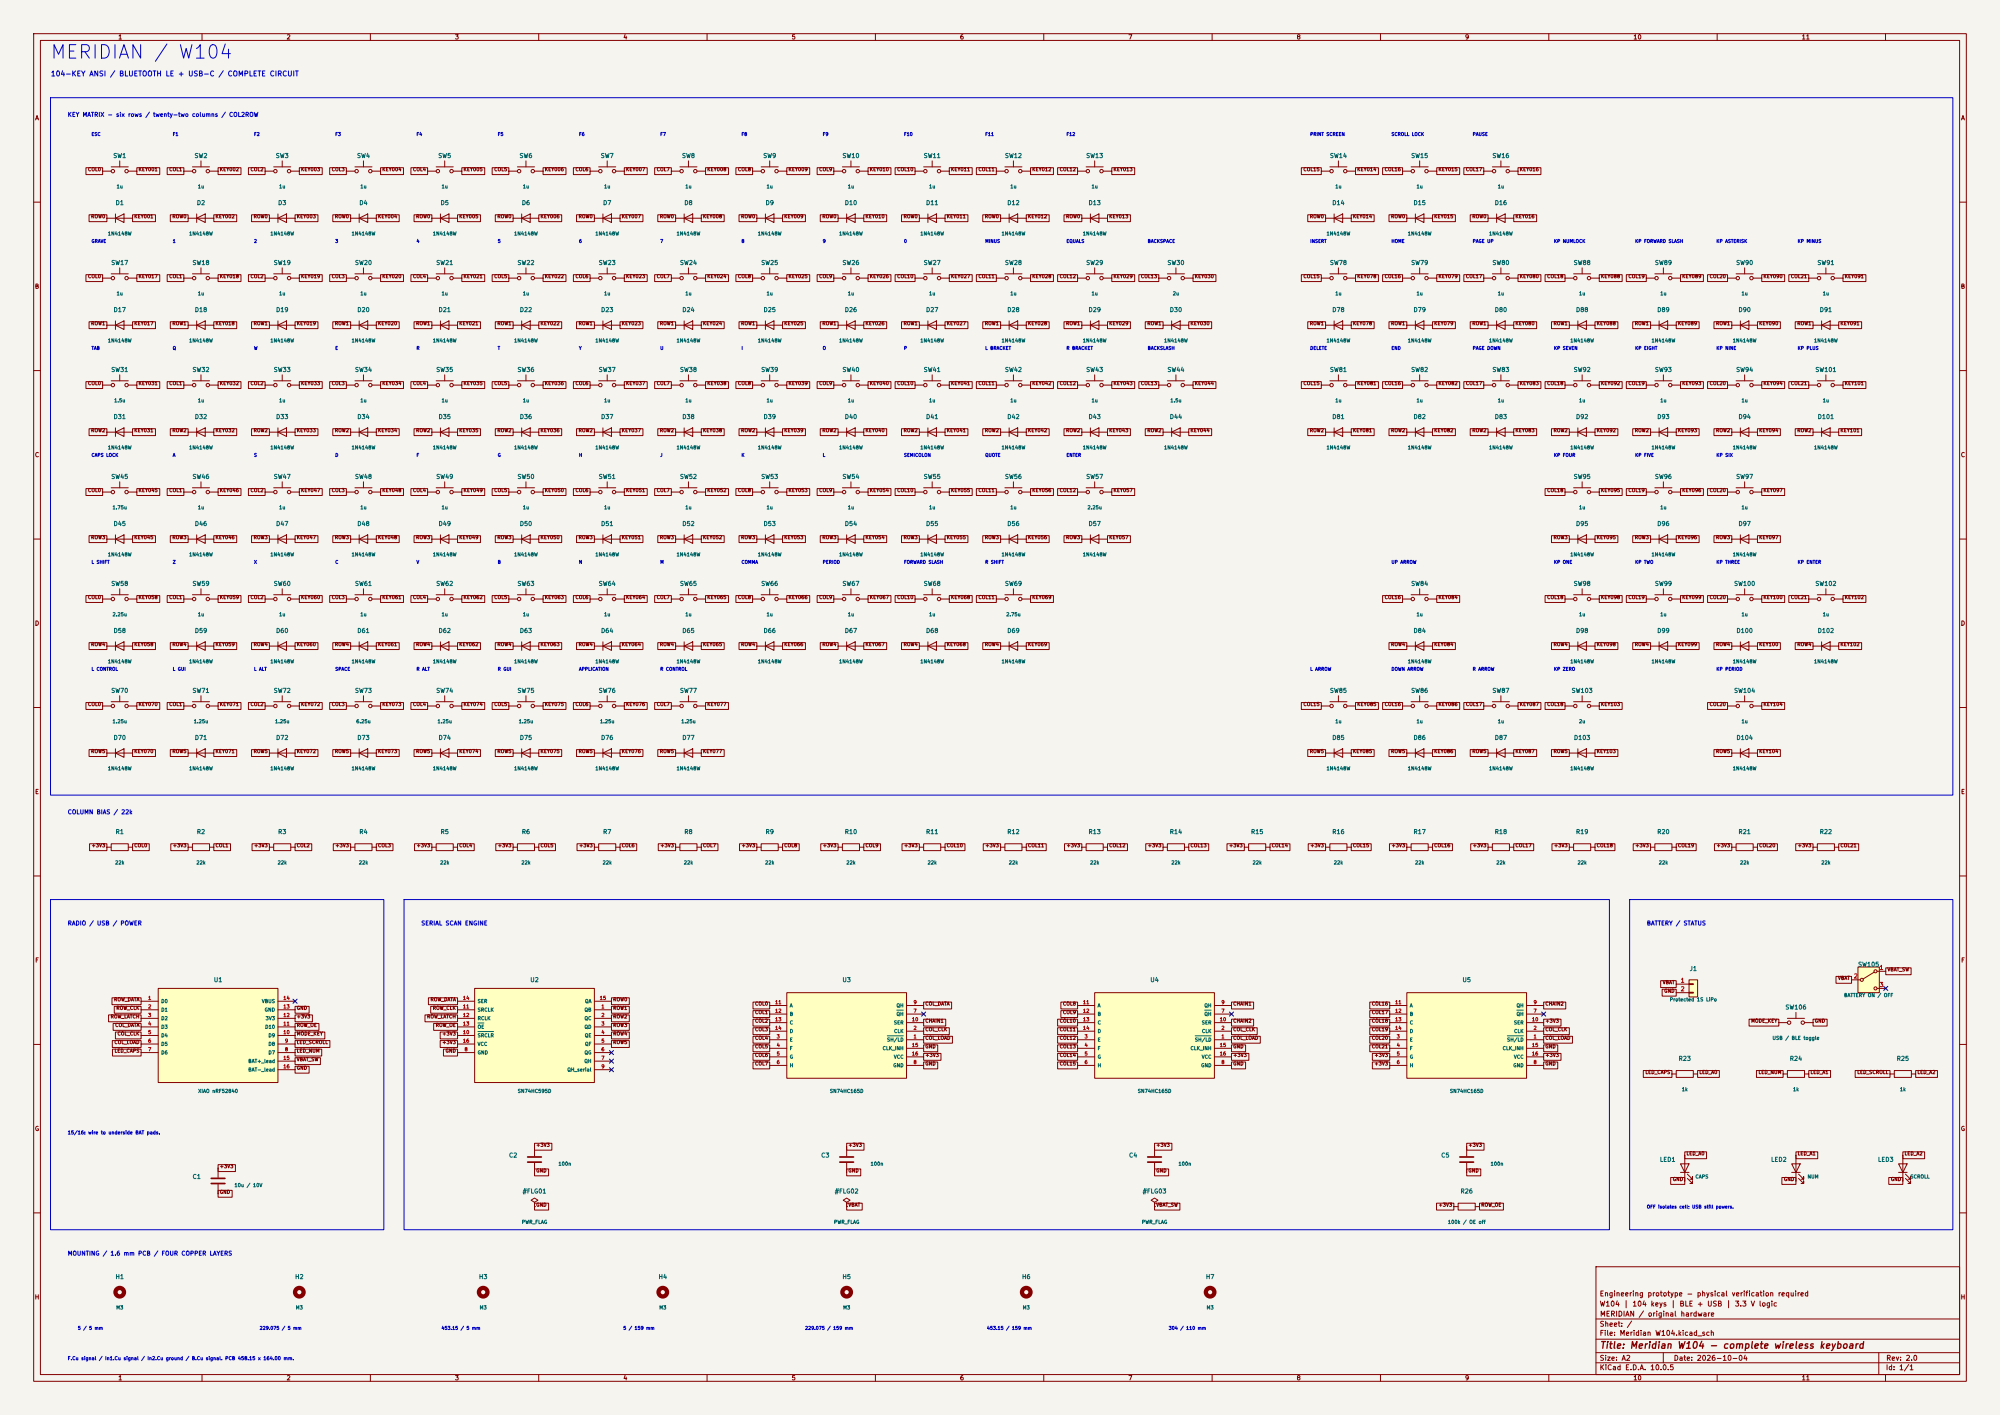
[picture p37: page 1]

F12 104-KEY ANSI / BLUETOOTH LE + USB-C / COMPLETE CIRCUIT

R BRACKET KEY MATRIX - six rows / twenty-two columns / COL2ROW

15/16: wire to underside BAT pads.

OFF isolates cell; USB still powers.

MOUNTING / 1.6 mm PCB / FOUR COPPER LAYERS

Engineering prototype - physical verification required
W104 | 104 keys | BLE + USB | 3.3 V logic
MERIDIAN / original hardware
Sheet: /
File: Meridian W104.kicad_sch
Title: Meridian W104 - complete wireless keyboard

Size: A2 | Rev: 2.0
KiCad E.D.A. 10.0.5 | Id: 1/1

F.Cu signal / In1.Cu signal / In2.Cu ground / B.Cu signal. PCB 458.15 x 164.00 mm.
