charancs926-png/Meridian-W104/PCB/Meridian W104.kicad_pcb

## KiCad design PCB/Meridian W104.kicad_pcb (2026-10-09)

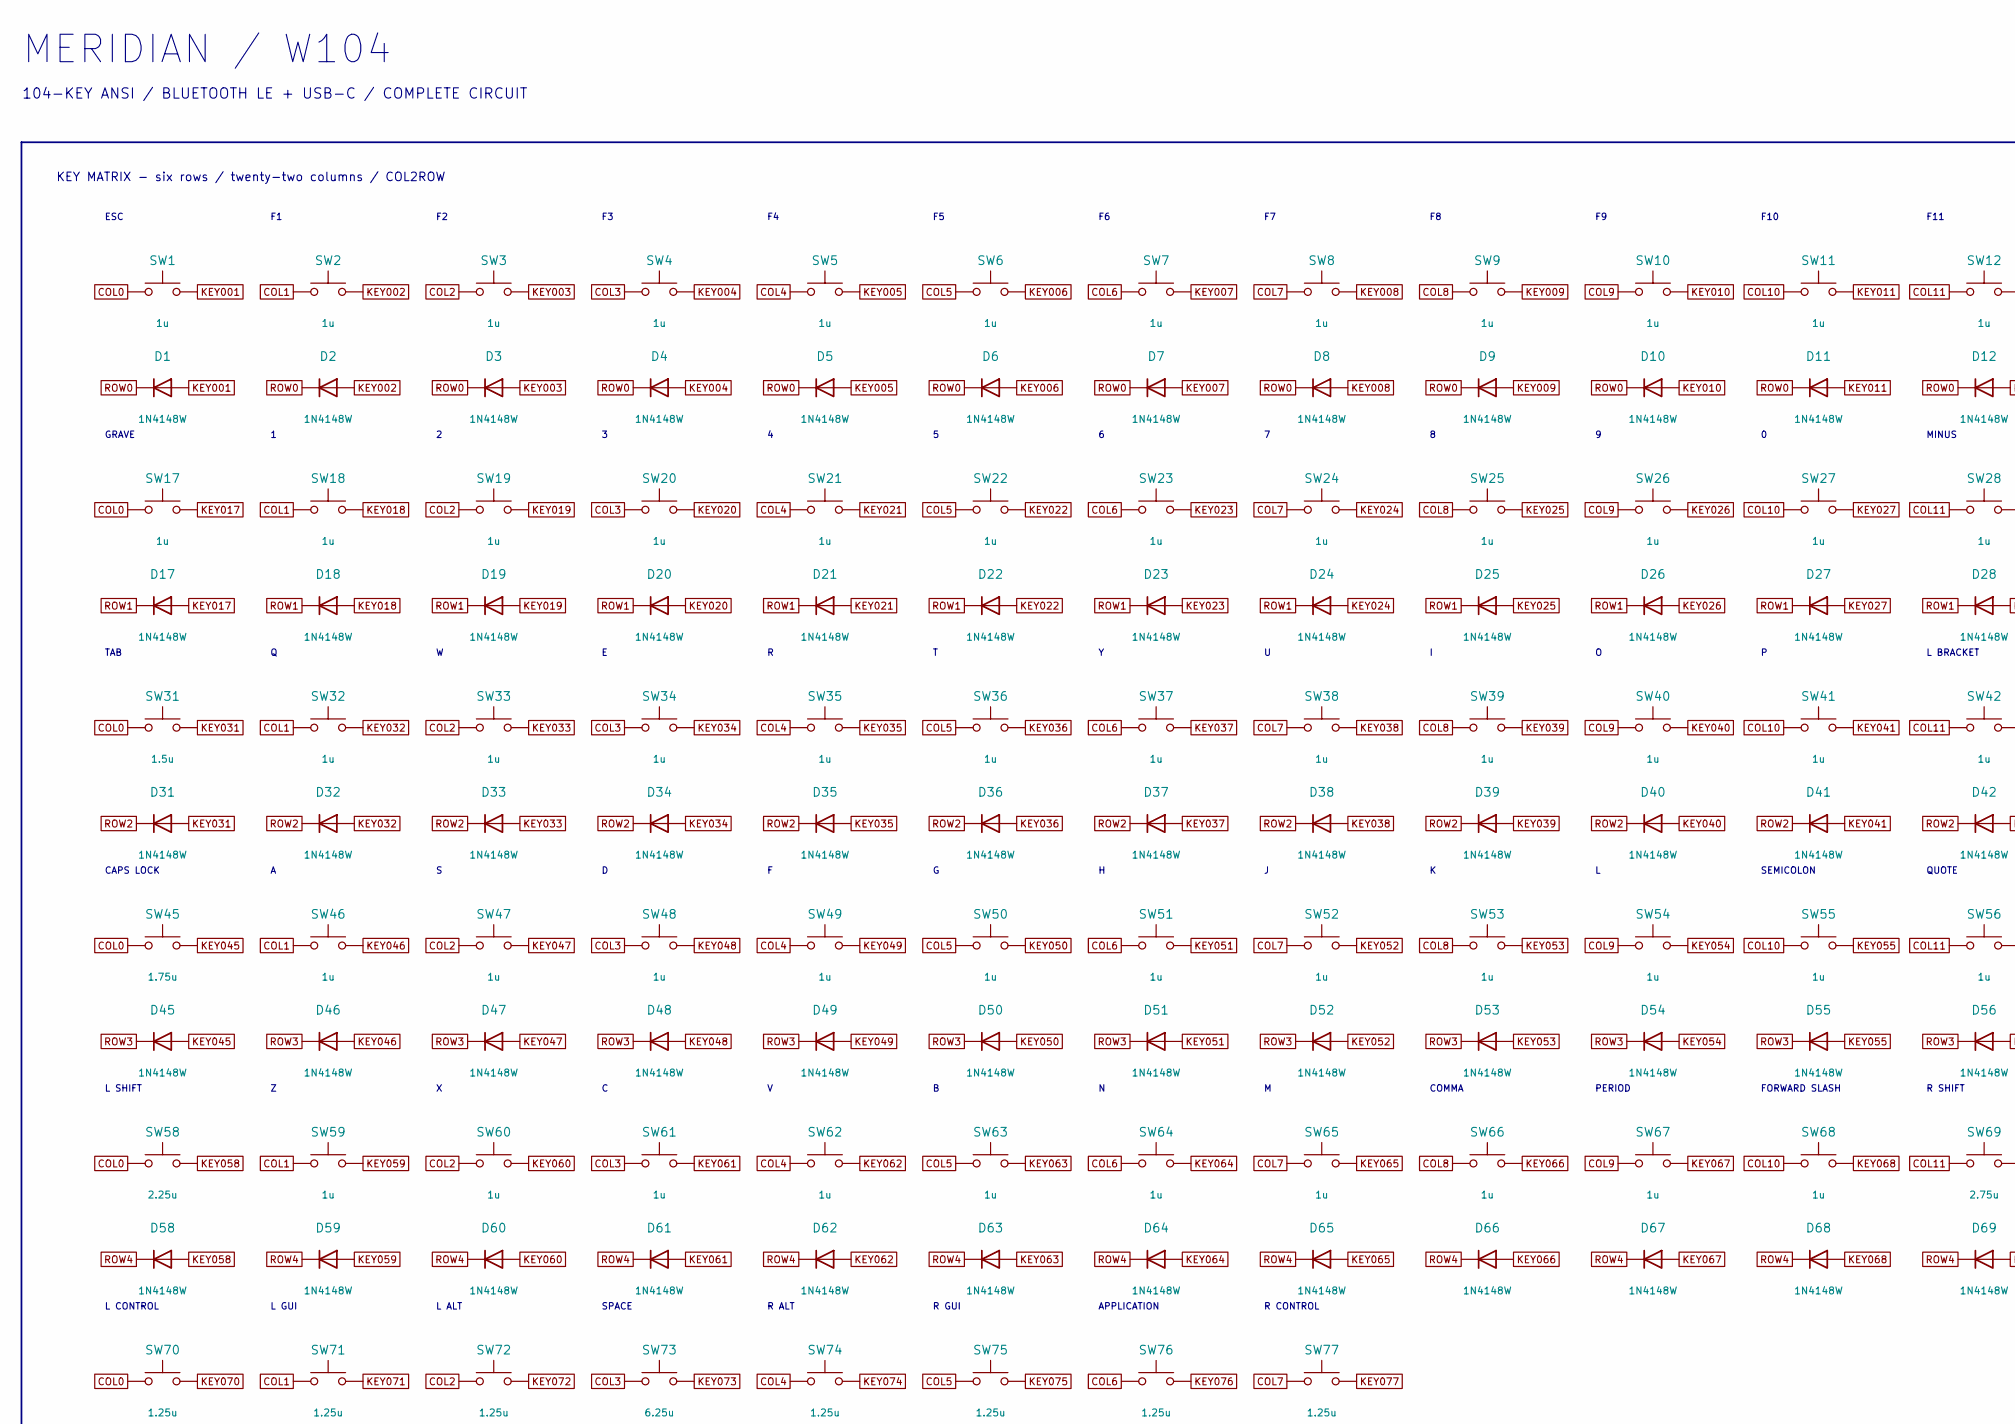
[picture p44: schematic Meridian W104.kicad_sch, Meridian W104 - complete wireless keyboard, part in row 1, column 1]

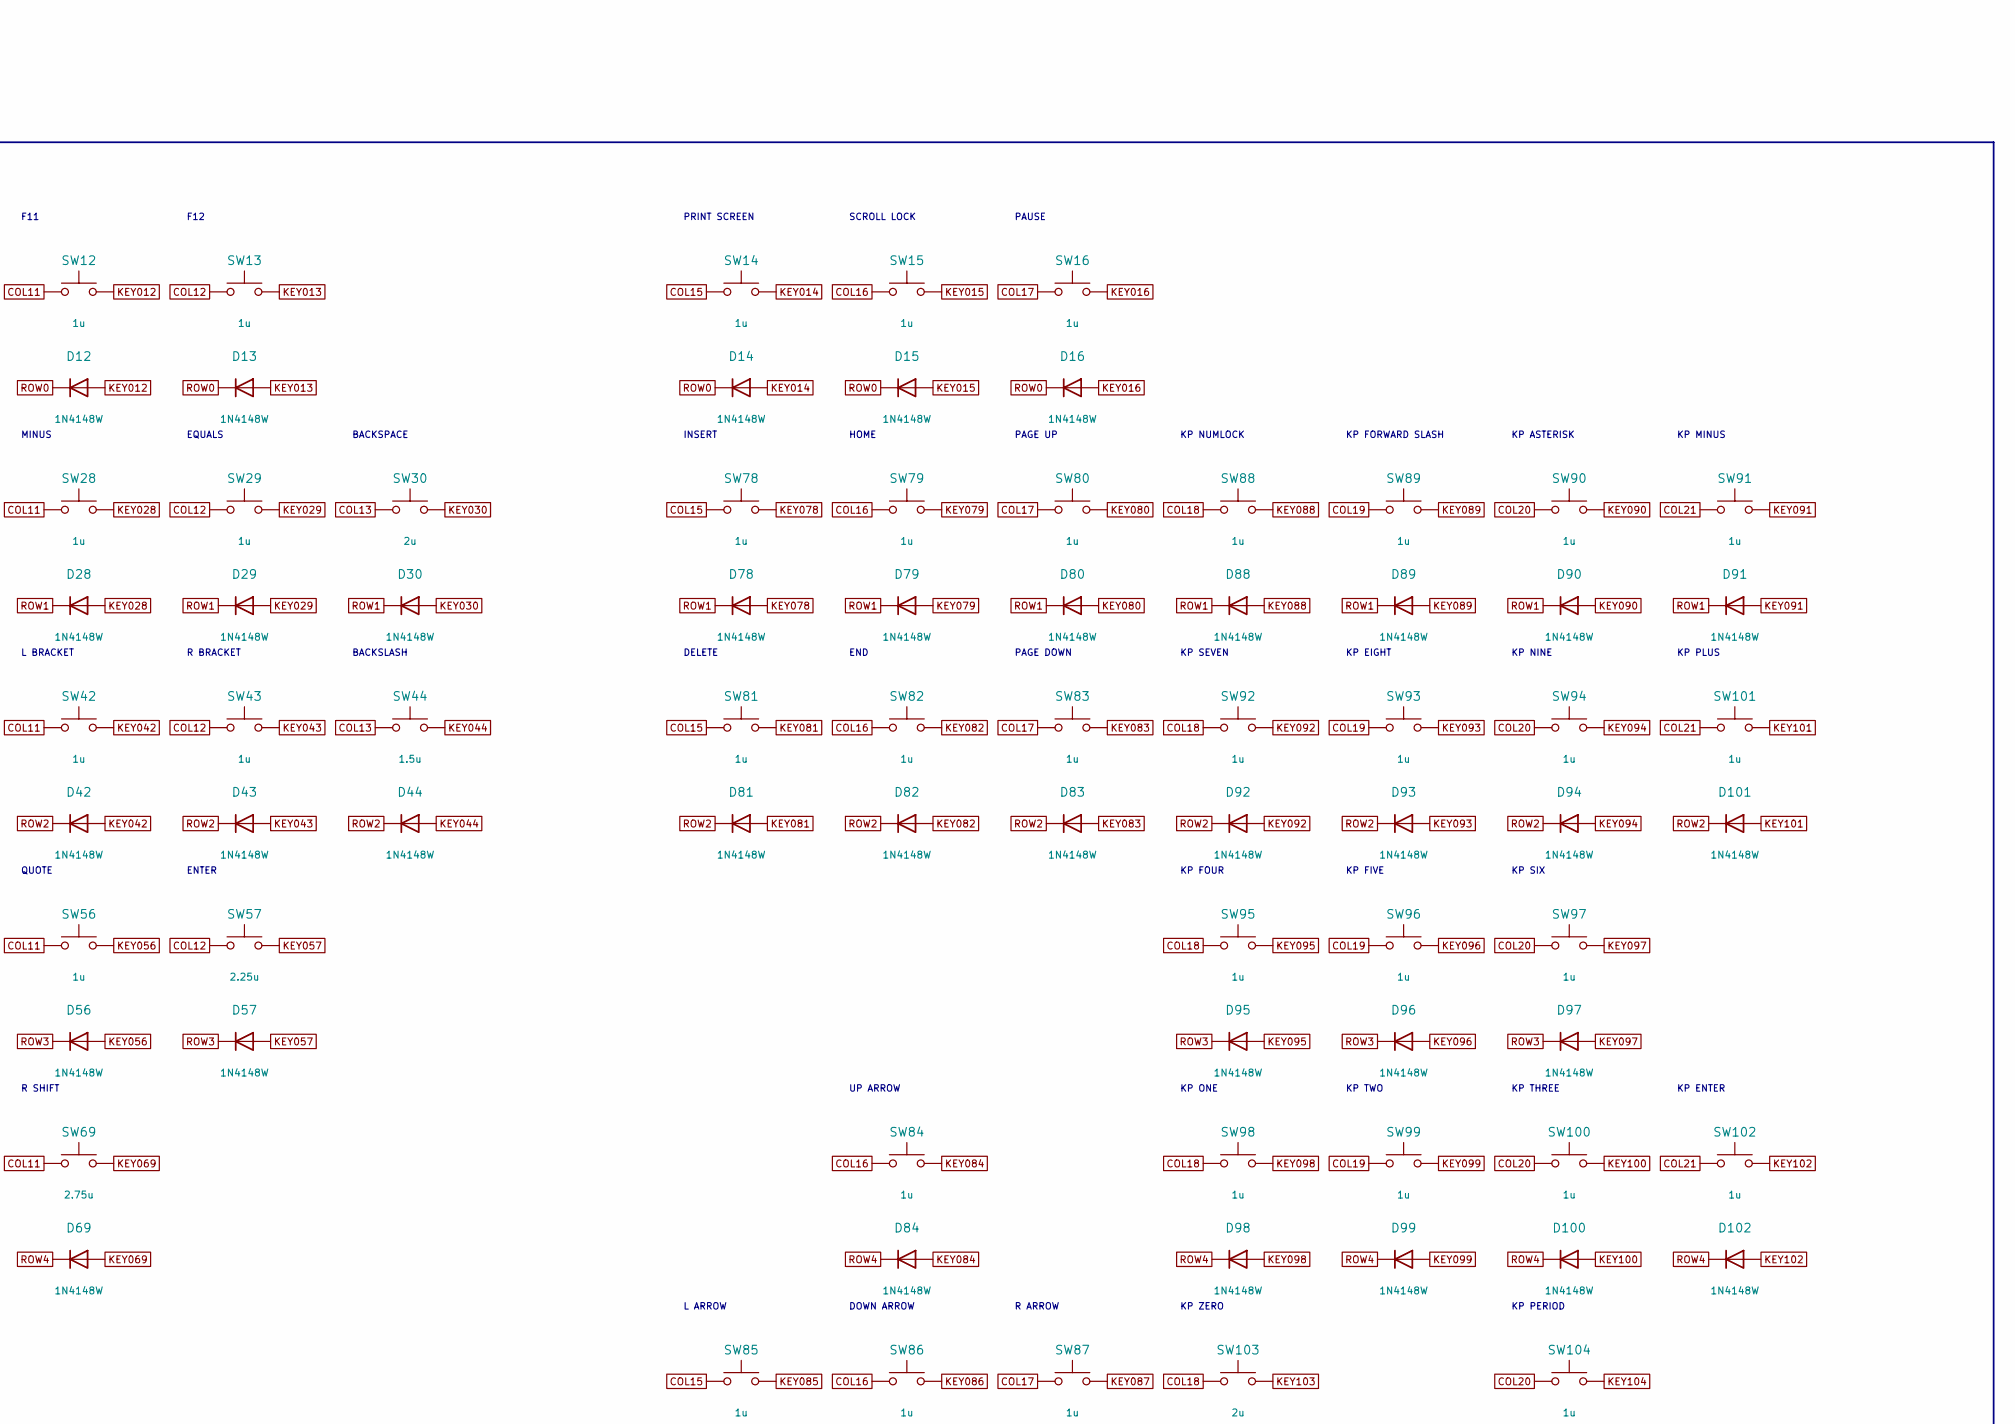
[picture p45: schematic Meridian W104.kicad_sch, Meridian W104 - complete wireless keyboard, part in row 1, column 2]

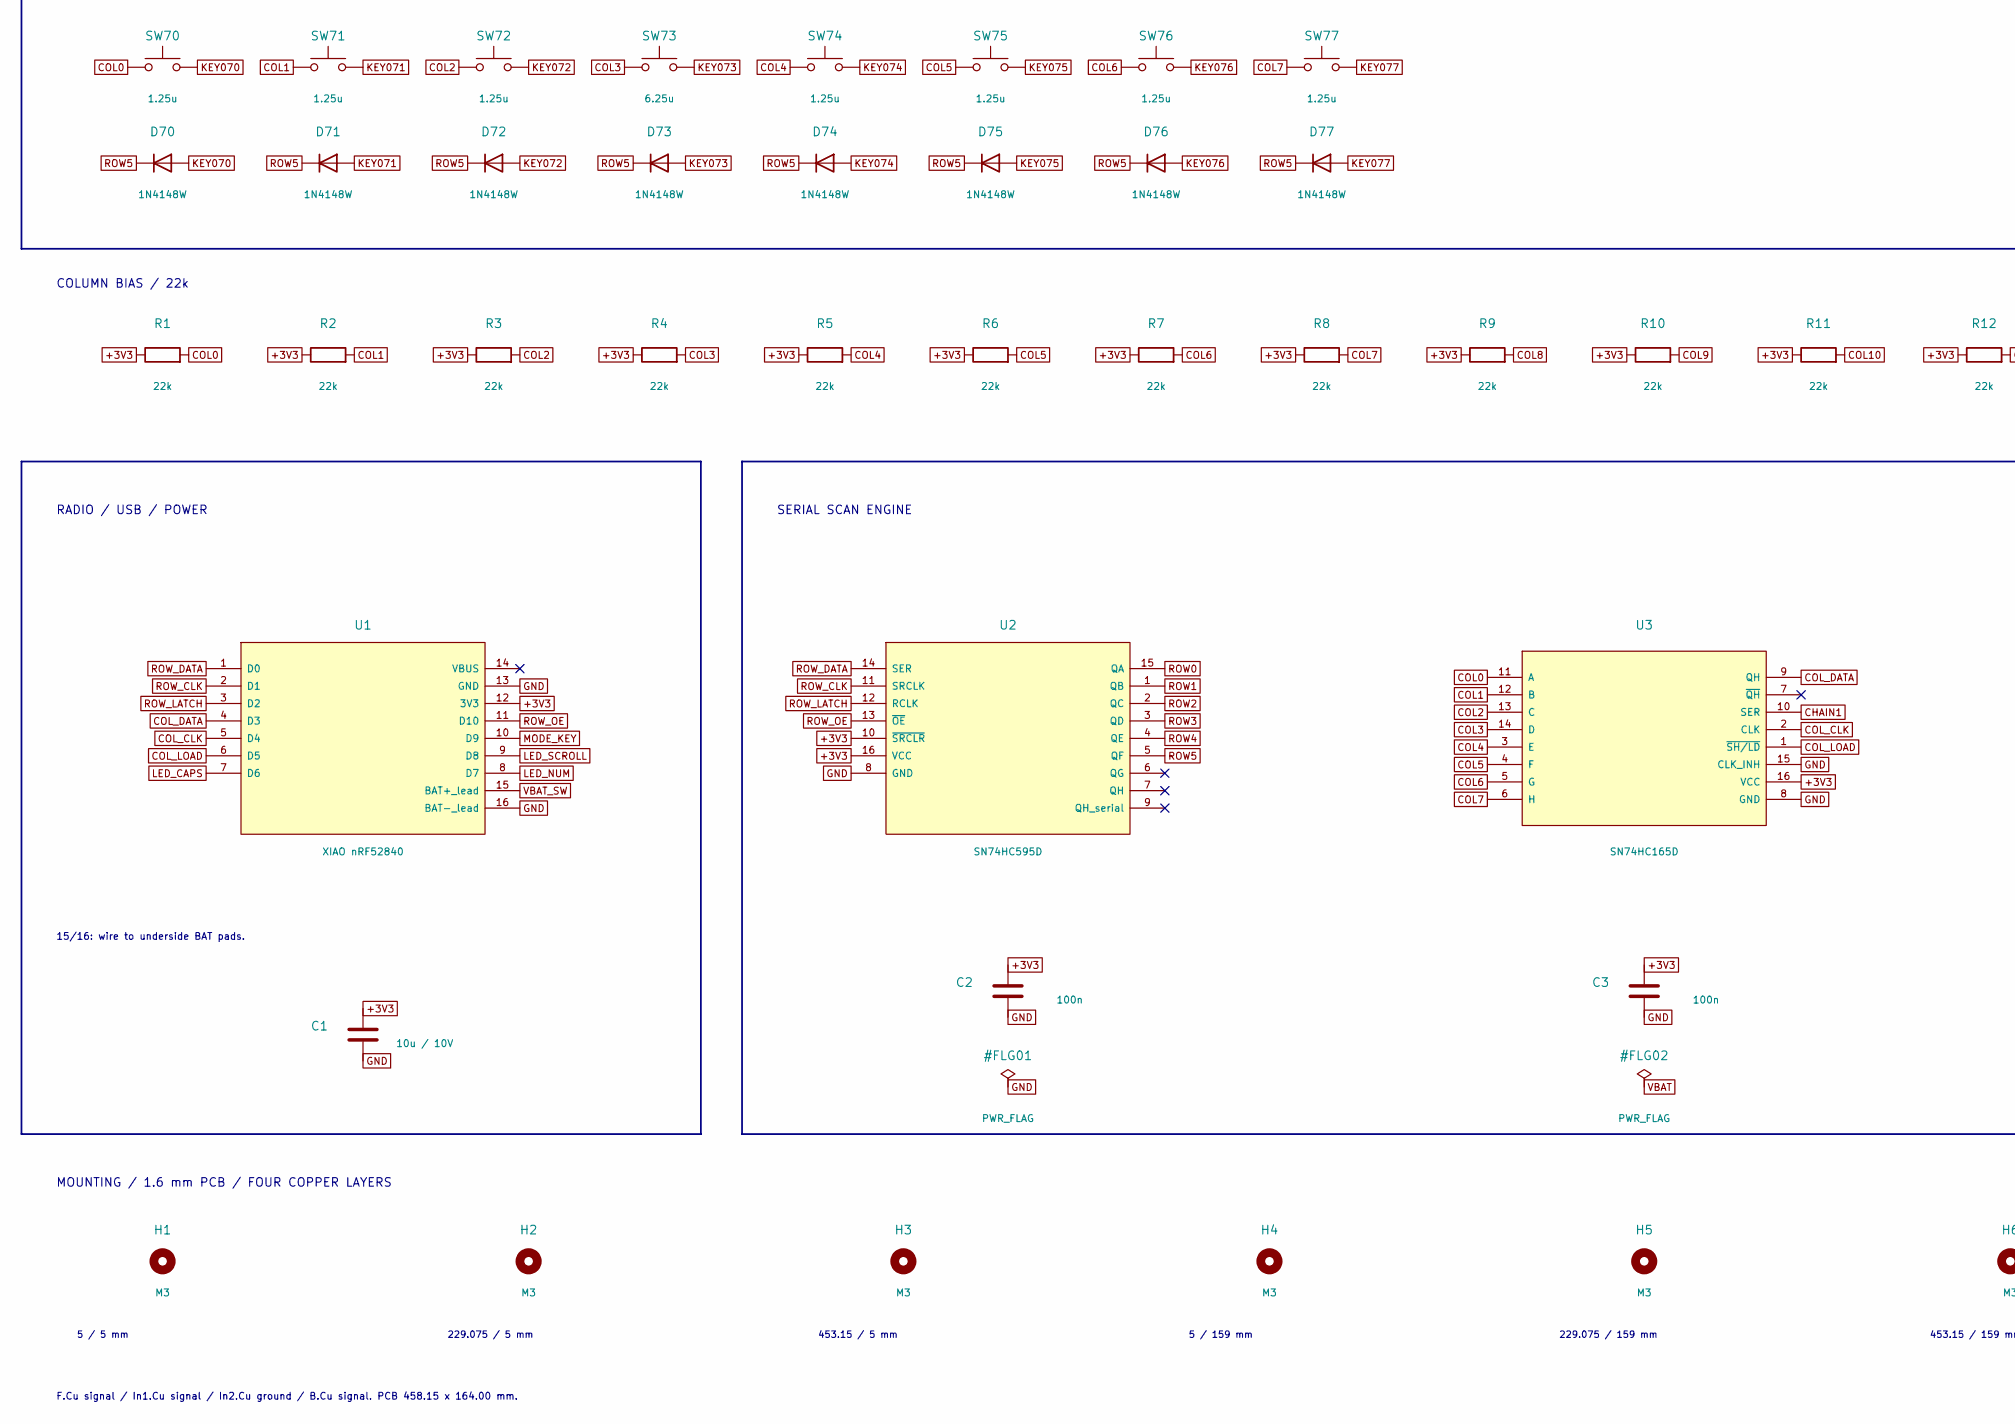
[picture p46: schematic Meridian W104.kicad_sch, Meridian W104 - complete wireless keyboard, part in row 2, column 1]

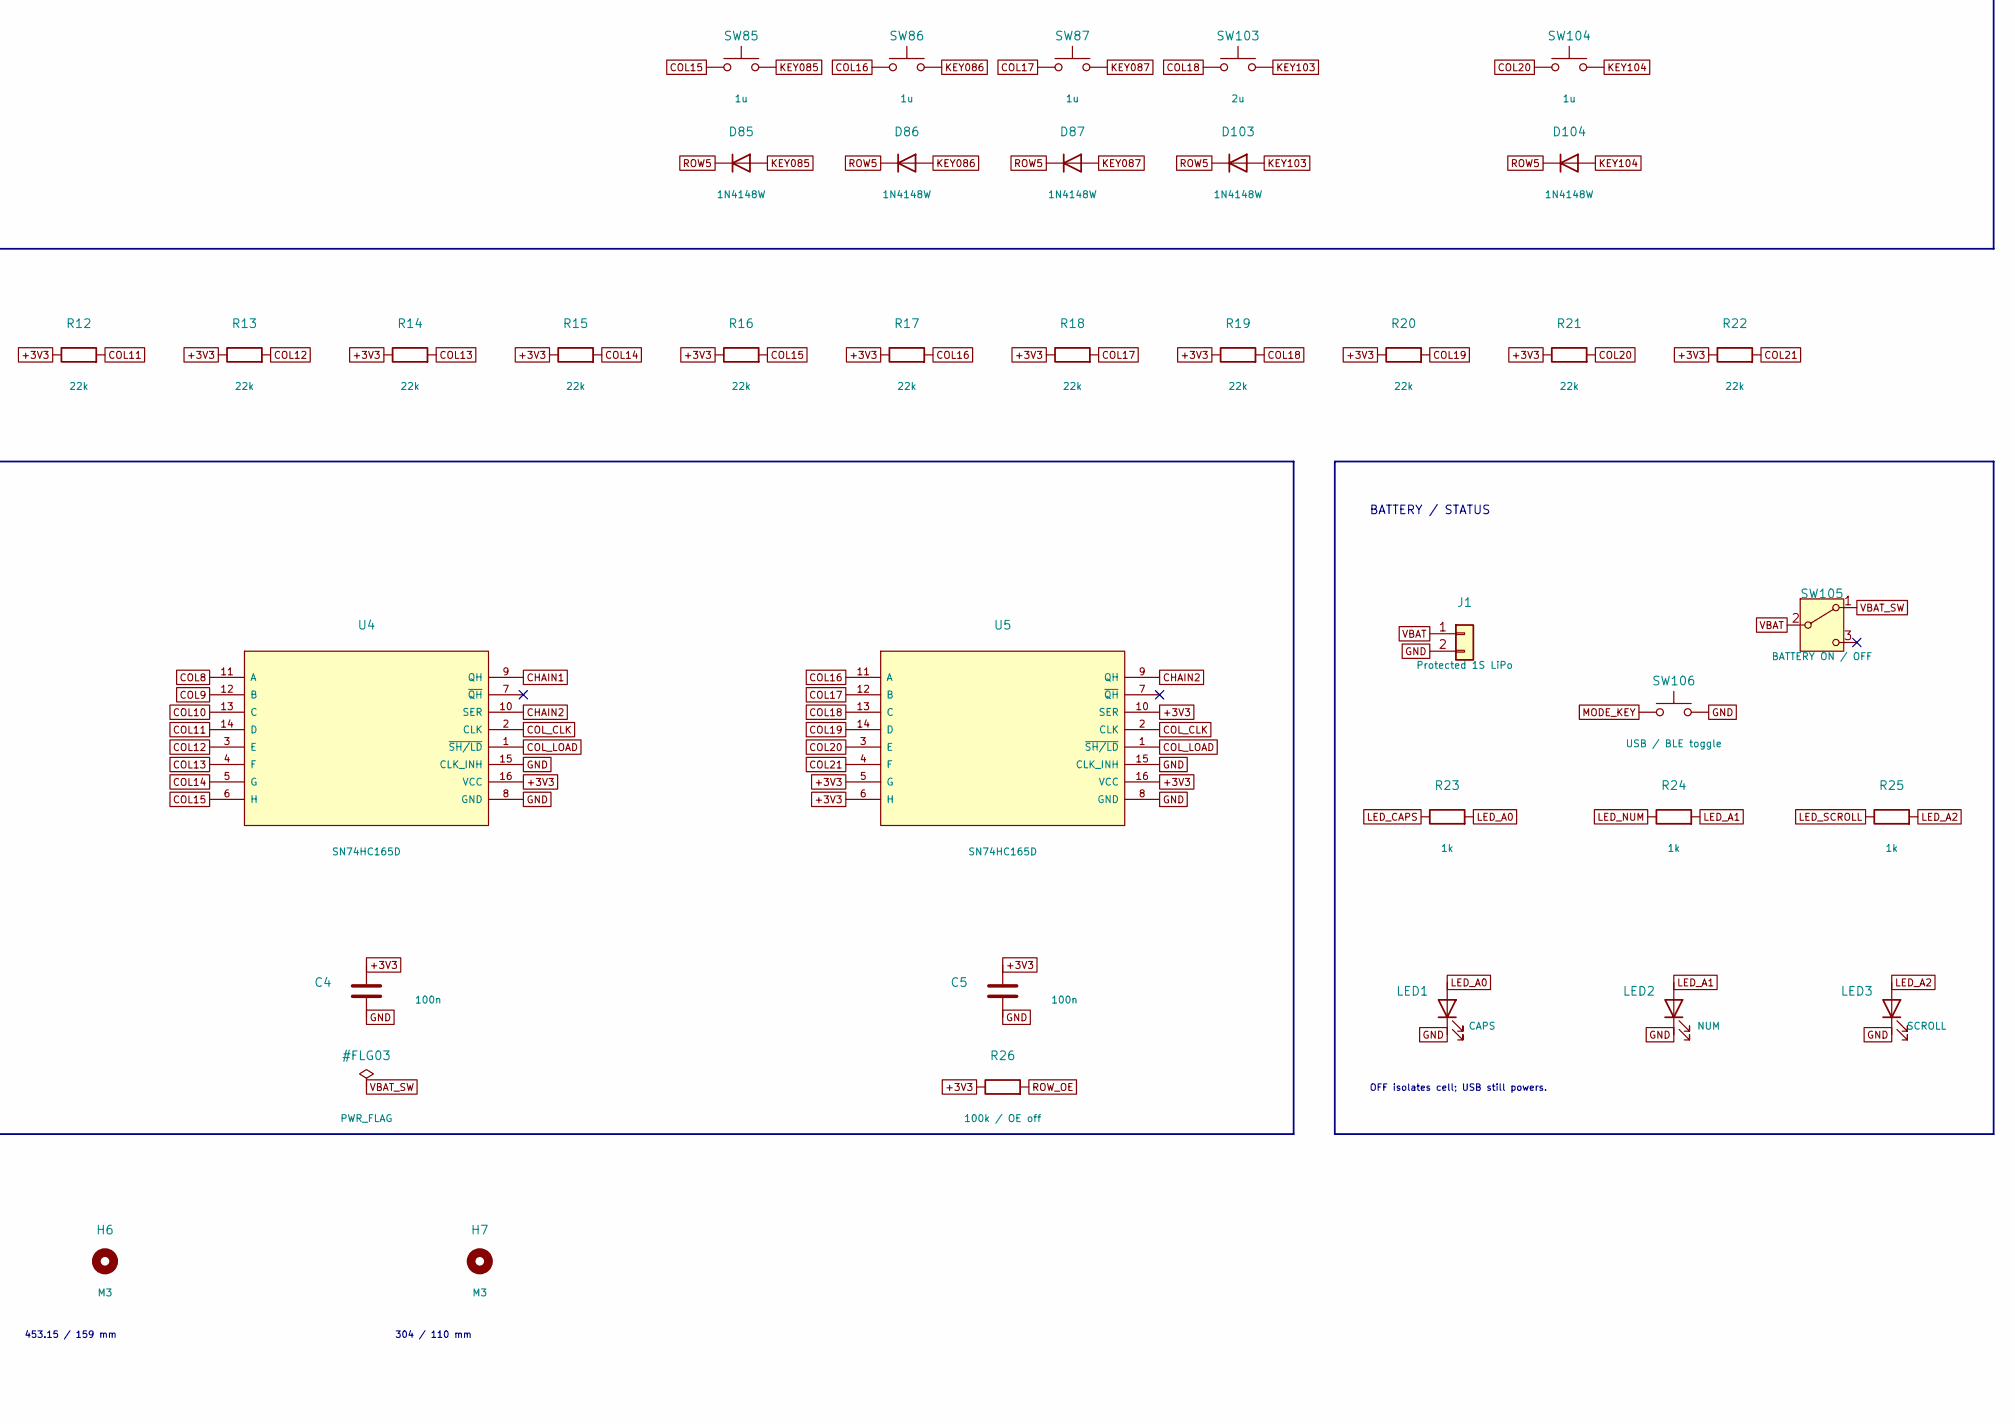
[picture p47: schematic Meridian W104.kicad_sch, Meridian W104 - complete wireless keyboard, part in row 2, column 2]

Parts:
C1: 10u / 10V; C_0805_2012Metric
C2, C3, C4, C5: 100n; C_0805_2012Metric
D1, D2, D3, D4, D5, D6, D7, D8, D9, D10, D11, D12, D13, D14, D15, D16, D17, D18, D19, D20, D21, D22, D23, D24, D25, D26, D27, D28, D29, D30, D31, D32, D33, D34, D35, D36, D37, D38, D39, D40, D41, D42, D43, D44, D45, D46, D47, D48, D49, D50, D51, D52, D53, D54, D55, D56, D57, D58, D59, D60, D61, D62, D63, D64, D65, D66, D67, D68, D69, D70, D71, D72, D73, D74, D75, D76, D77, D78, D79, D80, D81, D82, D83, D84, D85, D86, D87, D88, D89, D90, D91, D92, D93, D94, D95, D96, D97, D98, D99, D100, D101, D102, D103, D104: 1N4148W; D_SOD-123
H1, H2, H3, H4, H5, H6, H7: M3; MountingHole_3.2mm_M3
J1: Protected 1S LiPo; JST_PH_S2B-PH-K_1x02_P2.00mm_Horizontal
LED1: CAPS; LED_D3.0mm
LED2: NUM; LED_D3.0mm
LED3: SCROLL; LED_D3.0mm
R1, R2, R3, R4, R5, R6, R7, R8, R9, R10, R11, R12, R13, R14, R15, R16, R17, R18, R19, R20, R21, R22: 22k; R_0805_2012Metric
R23, R24, R25: 1k; R_0805_2012Metric
R26: 100k / OE off; R_0805_2012Metric
SW1, SW2, SW3, SW4, SW5, SW6, SW7, SW8, SW9, SW10, SW11, SW12, SW13, SW14, SW15, SW16, SW17, SW18, SW19, SW20, SW21, SW22, SW23, SW24, SW25, SW26, SW27, SW28, SW29, SW32, SW33, SW34, SW35, SW36, SW37, SW38, SW39, SW40, SW41, SW42, SW43, SW46, SW47, SW48, SW49, SW50, SW51, SW52, SW53, SW54, SW55, SW56, SW59, SW60, SW61, SW62, SW63, SW64, SW65, SW66, SW67, SW68, SW78, SW79, SW80, SW81, SW82, SW83, SW84, SW85, SW86, SW87, SW88, SW89, SW90, SW91, SW92, SW93, SW94, SW95, SW96, SW97, SW98, SW99, SW100, SW104: 1u; SW_Cherry_MX_1.00u_PCB
SW30, SW103: 2u; SW_Cherry_MX_2.00u_PCB
SW31, SW44: 1.5u; SW_Cherry_MX_1.50u_PCB
SW45: 1.75u; SW_Cherry_MX_1.75u_PCB
SW57, SW58: 2.25u; SW_Cherry_MX_2.25u_PCB
SW69: 2.75u; SW_Cherry_MX_2.75u_PCB
SW70, SW71, SW72, SW74, SW75, SW76, SW77: 1.25u; SW_Cherry_MX_1.25u_PCB
SW73: 6.25u; SW_Cherry_MX_6.25u_PCB
SW101, SW102: 1u; SW_Cherry_MX_2.00u_Vertical_PCB
SW105: BATTERY ON / OFF; SW_SPDT_PCM12
SW106: USB / BLE toggle; SW_PUSH_6mm
U1: XIAO nRF52840; XIAO_Carrier
U2: SN74HC595D; SOIC-16_3.9x9.9mm_P1.27mm
U3, U4, U5: SN74HC165D; SOIC-16_3.9x9.9mm_P1.27mm

Connections:
+3V3: C1.1, C2.1, C3.1, C4.1, C5.1, R1.1, R2.1, R3.1, R4.1, R5.1, R6.1, R7.1, R8.1, R9.1, R10.1, R11.1, R12.1, R13.1, R14.1, R15.1, R16.1, R17.1, R18.1, R19.1, R20.1, R21.1, R22.1, R26.1, U1.12 (3V3), U2.10 (~SRCLR), U2.16 (VCC), U3.16 (VCC), U4.16 (VCC), U5.5 (G), U5.6 (H), U5.10 (SER), U5.16 (VCC)
CHAIN1: U3.10 (SER), U4.9 (QH)
CHAIN2: U4.10 (SER), U5.9 (QH)
COL0: R1.2, SW1.1, SW17.1, SW31.1, SW45.1, SW58.1, SW70.1, U3.11 (A)
COL1: R2.2, SW2.1, SW18.1, SW32.1, SW46.1, SW59.1, SW71.1, U3.12 (B)
COL2: R3.2, SW3.1, SW19.1, SW33.1, SW47.1, SW60.1, SW72.1, U3.13 (C)
COL3: R4.2, SW4.1, SW20.1, SW34.1, SW48.1, SW61.1, SW73.1, U3.14 (D)
COL4: R5.2, SW5.1, SW21.1, SW35.1, SW49.1, SW62.1, SW74.1, U3.3 (E)
COL5: R6.2, SW6.1, SW22.1, SW36.1, SW50.1, SW63.1, SW75.1, U3.4 (F)
COL6: R7.2, SW7.1, SW23.1, SW37.1, SW51.1, SW64.1, SW76.1, U3.5 (G)
COL7: R8.2, SW8.1, SW24.1, SW38.1, SW52.1, SW65.1, SW77.1, U3.6 (H)
COL8: R9.2, SW9.1, SW25.1, SW39.1, SW53.1, SW66.1, U4.11 (A)
COL9: R10.2, SW10.1, SW26.1, SW40.1, SW54.1, SW67.1, U4.12 (B)
COL10: R11.2, SW11.1, SW27.1, SW41.1, SW55.1, SW68.1, U4.13 (C)
COL11: R12.2, SW12.1, SW28.1, SW42.1, SW56.1, SW69.1, U4.14 (D)
COL12: R13.2, SW13.1, SW29.1, SW43.1, SW57.1, U4.3 (E)
COL13: R14.2, SW30.1, SW44.1, U4.4 (F)
COL14: R15.2, U4.5 (G)
COL15: R16.2, SW14.1, SW78.1, SW81.1, SW85.1, U4.6 (H)
COL16: R17.2, SW15.1, SW79.1, SW82.1, SW84.1, SW86.1, U5.11 (A)
COL17: R18.2, SW16.1, SW80.1, SW83.1, SW87.1, U5.12 (B)
COL18: R19.2, SW88.1, SW92.1, SW95.1, SW98.1, SW103.1, U5.13 (C)
COL19: R20.2, SW89.1, SW93.1, SW96.1, SW99.1, U5.14 (D)
COL20: R21.2, SW90.1, SW94.1, SW97.1, SW100.1, SW104.1, U5.3 (E)
COL21: R22.2, SW91.1, SW101.1, SW102.1, U5.4 (F)
COL_CLK: U1.5 (D4), U3.2 (CLK), U4.2 (CLK), U5.2 (CLK)
COL_DATA: U1.4 (D3), U3.9 (QH)
COL_LOAD: U1.6 (D5), U3.1 (~SH/LD), U4.1 (~SH/LD), U5.1 (~SH/LD)
GND: C1.2, C2.2, C3.2, C4.2, C5.2, J1.2, LED1.1 (K), LED2.1 (K), LED3.1 (K), SW106.2, U1.13 (GND), U1.16 (BAT-_lead), U2.8 (GND), U3.8 (GND), U3.15 (CLK_INH), U4.8 (GND), U4.15 (CLK_INH), U5.8 (GND), U5.15 (CLK_INH)
KEY001: D1.2 (A), SW1.2
KEY002: D2.2 (A), SW2.2
KEY003: D3.2 (A), SW3.2
KEY004: D4.2 (A), SW4.2
KEY005: D5.2 (A), SW5.2
KEY006: D6.2 (A), SW6.2
KEY007: D7.2 (A), SW7.2
KEY008: D8.2 (A), SW8.2
KEY009: D9.2 (A), SW9.2
KEY010: D10.2 (A), SW10.2
KEY011: D11.2 (A), SW11.2
KEY012: D12.2 (A), SW12.2
KEY013: D13.2 (A), SW13.2
KEY014: D14.2 (A), SW14.2
KEY015: D15.2 (A), SW15.2
KEY016: D16.2 (A), SW16.2
KEY017: D17.2 (A), SW17.2
KEY018: D18.2 (A), SW18.2
KEY019: D19.2 (A), SW19.2
KEY020: D20.2 (A), SW20.2
KEY021: D21.2 (A), SW21.2
KEY022: D22.2 (A), SW22.2
KEY023: D23.2 (A), SW23.2
KEY024: D24.2 (A), SW24.2
KEY025: D25.2 (A), SW25.2
KEY026: D26.2 (A), SW26.2
KEY027: D27.2 (A), SW27.2
KEY028: D28.2 (A), SW28.2
KEY029: D29.2 (A), SW29.2
KEY030: D30.2 (A), SW30.2
KEY031: D31.2 (A), SW31.2
KEY032: D32.2 (A), SW32.2
KEY033: D33.2 (A), SW33.2
KEY034: D34.2 (A), SW34.2
KEY035: D35.2 (A), SW35.2
KEY036: D36.2 (A), SW36.2
KEY037: D37.2 (A), SW37.2
KEY038: D38.2 (A), SW38.2
KEY039: D39.2 (A), SW39.2
KEY040: D40.2 (A), SW40.2
KEY041: D41.2 (A), SW41.2
KEY042: D42.2 (A), SW42.2
KEY043: D43.2 (A), SW43.2
KEY044: D44.2 (A), SW44.2
KEY045: D45.2 (A), SW45.2
KEY046: D46.2 (A), SW46.2
KEY047: D47.2 (A), SW47.2
KEY048: D48.2 (A), SW48.2
KEY049: D49.2 (A), SW49.2
KEY050: D50.2 (A), SW50.2
KEY051: D51.2 (A), SW51.2
KEY052: D52.2 (A), SW52.2
KEY053: D53.2 (A), SW53.2
KEY054: D54.2 (A), SW54.2
KEY055: D55.2 (A), SW55.2
KEY056: D56.2 (A), SW56.2
KEY057: D57.2 (A), SW57.2
KEY058: D58.2 (A), SW58.2
KEY059: D59.2 (A), SW59.2
KEY060: D60.2 (A), SW60.2
KEY061: D61.2 (A), SW61.2
KEY062: D62.2 (A), SW62.2
KEY063: D63.2 (A), SW63.2
KEY064: D64.2 (A), SW64.2
KEY065: D65.2 (A), SW65.2
KEY066: D66.2 (A), SW66.2
KEY067: D67.2 (A), SW67.2
KEY068: D68.2 (A), SW68.2
KEY069: D69.2 (A), SW69.2
KEY070: D70.2 (A), SW70.2
KEY071: D71.2 (A), SW71.2
KEY072: D72.2 (A), SW72.2
KEY073: D73.2 (A), SW73.2
KEY074: D74.2 (A), SW74.2
KEY075: D75.2 (A), SW75.2
KEY076: D76.2 (A), SW76.2
KEY077: D77.2 (A), SW77.2
KEY078: D78.2 (A), SW78.2
KEY079: D79.2 (A), SW79.2
KEY080: D80.2 (A), SW80.2
KEY081: D81.2 (A), SW81.2
KEY082: D82.2 (A), SW82.2
KEY083: D83.2 (A), SW83.2
KEY084: D84.2 (A), SW84.2
KEY085: D85.2 (A), SW85.2
KEY086: D86.2 (A), SW86.2
KEY087: D87.2 (A), SW87.2
KEY088: D88.2 (A), SW88.2
KEY089: D89.2 (A), SW89.2
KEY090: D90.2 (A), SW90.2
KEY091: D91.2 (A), SW91.2
KEY092: D92.2 (A), SW92.2
KEY093: D93.2 (A), SW93.2
KEY094: D94.2 (A), SW94.2
KEY095: D95.2 (A), SW95.2
KEY096: D96.2 (A), SW96.2
KEY097: D97.2 (A), SW97.2
KEY098: D98.2 (A), SW98.2
KEY099: D99.2 (A), SW99.2
KEY100: D100.2 (A), SW100.2
KEY101: D101.2 (A), SW101.2
KEY102: D102.2 (A), SW102.2
KEY103: D103.2 (A), SW103.2
KEY104: D104.2 (A), SW104.2
LED_A0: LED1.2 (A), R23.2
LED_A1: LED2.2 (A), R24.2
LED_A2: LED3.2 (A), R25.2
LED_CAPS: R23.1, U1.7 (D6)
LED_NUM: R24.1, U1.8 (D7)
LED_SCROLL: R25.1, U1.9 (D8)
MODE_KEY: SW106.1, U1.10 (D9)
ROW0: D1.1 (K), D2.1 (K), D3.1 (K), D4.1 (K), D5.1 (K), D6.1 (K), D7.1 (K), D8.1 (K), D9.1 (K), D10.1 (K), D11.1 (K), D12.1 (K), D13.1 (K), D14.1 (K), D15.1 (K), D16.1 (K), U2.15 (QA)
ROW1: D17.1 (K), D18.1 (K), D19.1 (K), D20.1 (K), D21.1 (K), D22.1 (K), D23.1 (K), D24.1 (K), D25.1 (K), D26.1 (K), D27.1 (K), D28.1 (K), D29.1 (K), D30.1 (K), D78.1 (K), D79.1 (K), D80.1 (K), D88.1 (K), D89.1 (K), D90.1 (K), D91.1 (K), U2.1 (QB)
ROW2: D31.1 (K), D32.1 (K), D33.1 (K), D34.1 (K), D35.1 (K), D36.1 (K), D37.1 (K), D38.1 (K), D39.1 (K), D40.1 (K), D41.1 (K), D42.1 (K), D43.1 (K), D44.1 (K), D81.1 (K), D82.1 (K), D83.1 (K), D92.1 (K), D93.1 (K), D94.1 (K), D101.1 (K), U2.2 (QC)
ROW3: D45.1 (K), D46.1 (K), D47.1 (K), D48.1 (K), D49.1 (K), D50.1 (K), D51.1 (K), D52.1 (K), D53.1 (K), D54.1 (K), D55.1 (K), D56.1 (K), D57.1 (K), D95.1 (K), D96.1 (K), D97.1 (K), U2.3 (QD)
ROW4: D58.1 (K), D59.1 (K), D60.1 (K), D61.1 (K), D62.1 (K), D63.1 (K), D64.1 (K), D65.1 (K), D66.1 (K), D67.1 (K), D68.1 (K), D69.1 (K), D84.1 (K), D98.1 (K), D99.1 (K), D100.1 (K), D102.1 (K), U2.4 (QE)
ROW5: D70.1 (K), D71.1 (K), D72.1 (K), D73.1 (K), D74.1 (K), D75.1 (K), D76.1 (K), D77.1 (K), D85.1 (K), D86.1 (K), D87.1 (K), D103.1 (K), D104.1 (K), U2.5 (QF)
ROW_CLK: U1.2 (D1), U2.11 (SRCLK)
ROW_DATA: U1.1 (D0), U2.14 (SER)
ROW_LATCH: U1.3 (D2), U2.12 (RCLK)
ROW_OE: R26.2, U1.11 (D10), U2.13 (~OE)
VBAT: J1.1, SW105.2 (B)
VBAT_SW: SW105.1 (A), U1.15 (BAT+_lead)

Notes on the sheet:
UP ARROW
KP SEVEN
L ALT
PAUSE
EQUALS
MINUS
KEY MATRIX - six rows / twenty-two columns / COL2ROW
END
5 / 5 mm
MERIDIAN / W104
KP TWO
104-KEY ANSI / BLUETOOTH LE + USB-C / COMPLETE CIRCUIT
SPACE
DELETE
OFF isolates cell; USB still powers.
INSERT
R SHIFT
FORWARD SLASH
KP PERIOD
SEMICOLON
L GUI
KP FORWARD SLASH
L ARROW
453.15 / 5 mm
KP THREE
KP ENTER
229.075 / 159 mm
F10
R GUI
R BRACKET
SERIAL SCAN ENGINE
COMMA
KP MINUS
304 / 110 mm
BACKSLASH
KP NUMLOCK
L SHIFT
PAGE DOWN
F.Cu signal / In1.Cu signal / In2.Cu ground / B.Cu signal. PCB 458.15 x 164.00 mm.
KP PLUS
QUOTE
APPLICATION
HOME
F11
L BRACKET
DOWN ARROW
PRINT SCREEN
RADIO / USB / POWER
MOUNTING / 1.6 mm PCB / FOUR COPPER LAYERS
PAGE UP
KP FIVE
TAB
CAPS LOCK
GRAVE
L CONTROL
R ARROW
R CONTROL
F12
15/16: wire to underside BAT pads.
PERIOD
KP ONE
ESC
COLUMN BIAS / 22k
KP NINE
KP ASTERISK
SCROLL LOCK
453.15 / 159 mm
BACKSPACE
229.075 / 5 mm
KP FOUR
KP EIGHT
ENTER
BATTERY / STATUS
5 / 159 mm
KP SIX
R ALT
KP ZERO

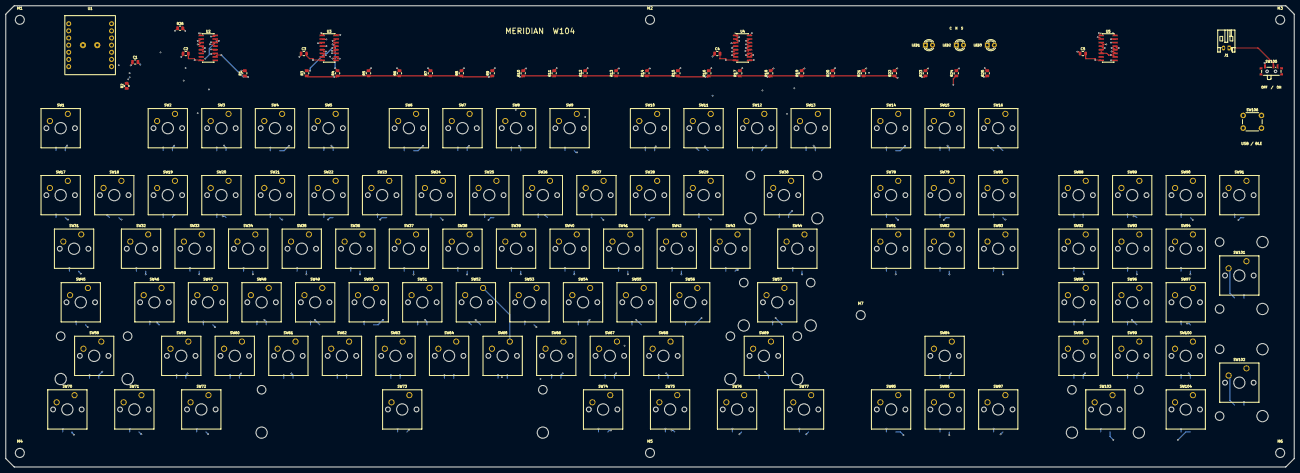
[picture p48: board Meridian W104.kicad_pcb from above]

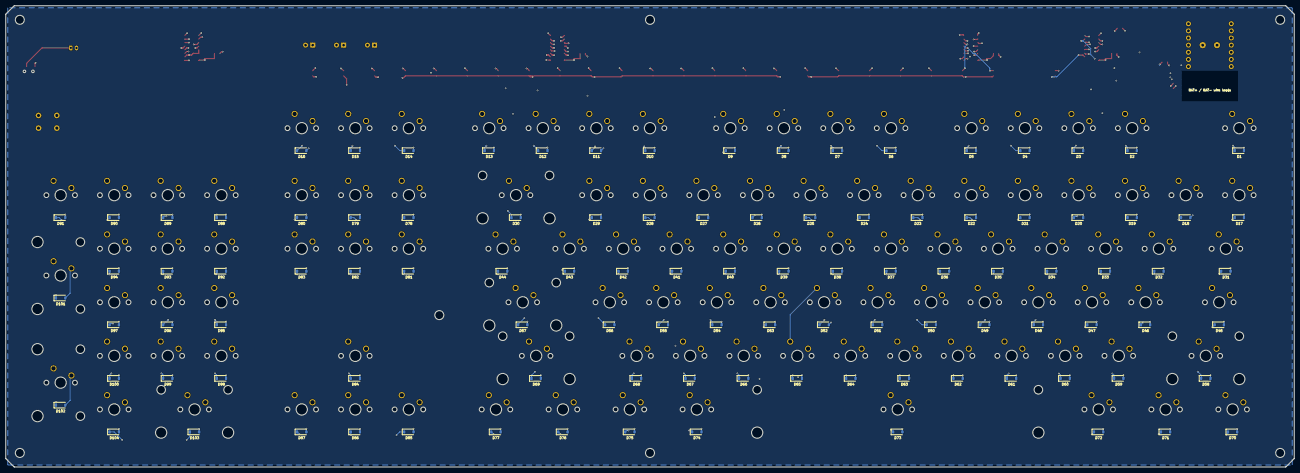
[picture p49: board Meridian W104.kicad_pcb from below]

Board: 4 copper layers, 458.1 x 164.0 mm, 257 parts (104 on the bottom side), 152 nets.
