charancs926-png/Meridian-W104/Firmware/keymap.py

# Meridian W104 - original 6x22 matrix map. USB HID usage IDs.
# Slot = row * 22 + column. Zero entries are physically absent keys.
KEYMAP = (
    41, 58, 59, 60, 61, 62, 63, 64, 65, 66, 67, 68, 69, 0, 0, 70, 71, 72, 0, 0, 0, 0,  # row 0
    53, 30, 31, 32, 33, 34, 35, 36, 37, 38, 39, 45, 46, 42, 0, 73, 74, 75, 83, 84, 85, 86,  # row 1
    43, 20, 26, 8, 21, 23, 28, 24, 12, 18, 19, 47, 48, 49, 0, 76, 77, 78, 95, 96, 97, 87,  # row 2
    57, 4, 22, 7, 9, 10, 11, 13, 14, 15, 51, 52, 40, 0, 0, 0, 0, 0, 92, 93, 94, 0,  # row 3
    225, 29, 27, 6, 25, 5, 17, 16, 54, 55, 56, 229, 0, 0, 0, 0, 82, 0, 89, 90, 91, 88,  # row 4
    224, 227, 226, 44, 230, 231, 101, 228, 0, 0, 0, 0, 0, 0, 0, 80, 81, 79, 98, 0, 99, 0,  # row 5
)
